UMSAE-Formula-Electric/PCB-ACU-LVPower/Schematics/2018_ACU_LVPWR_rev1.PcbDoc.htm

Reporting Options

# File in Previous Format

Date | : | 2021-02-05
Time | : | 9:37:32 PM
Filename | : | C:\Users\serge\OneDrive\Documents\UMSAE Formula Electric\2019\LV Power\trunk\2018_ACU_LVPWR_rev1.PcbDoc

Version | Warning

This file was generated by an earlier version of the software
