UMSAE-Formula-Electric/PCB-ACU-LVPower/Project Outputs for ePBR23_ACU_Power/ePBR23_ACU_Power.xlsx

Name | Description | Designator | Revision ID | Revision State | Revision Status | Quantity | Manufacturer 1 | Manufacturer Part Number 1 | Manufacturer Lifecycle 1 | Supplier 1 | Supplier Part Number 1 | Supplier Unit Price 1 | Supplier Subtotal 1
Test Via |  | 3V3, 5V, ACU_PWR, LATCHING_Delayed, UV_DELAY, VBATT_RAW, VS, VS_FROM_MS, VS_TO_MS |  | Not managed |  | 9
Cap | Capacitor | C1, C2, C11, C13 |  | Not managed |  | 4 | Samsung | CL10A106MA8NRNC | Volume Production | Digi-Key | 1276-1869-1-ND | 0.35081 | 1.4
Cap Semi | Capacitor (Semiconductor SIM Model) | C3, C12, C14, C15, C17, C18, C19, C20, C21 |  | Not managed |  | 9 | Murata | ZRB18AR61E106ME01L | Volume Production | Digi-Key | 490-10991-1-ND | 16.42 | 164.21
Cap Semi | Capacitor (Semiconductor SIM Model) | C4, C5 |  | Not managed |  | 2 | Murata | GCM188R91E104KA37D | Volume Production | Digi-Key | 490-14359-1-ND | 0.25636 | 0.51272
UUD1H101MNL1GS | Aluminum Electrolytic Capacitor, UD Series, Low Impedance, 100 uF, 50 V, + / - 20%, -55 to 105 degC, Chip Type, 8 x 10 mm D x L, Pb-Free, Reel | C6, C9 | CMP-0687-00073-1 | Released | Up to date | 2 | Nichicon | UUD1H101MNL1GS | Volume Production | Farnell | 8823391 | 0.77503 | 1.55
Cap Semi | Capacitor (Semiconductor SIM Model) | C10 |  | Not managed |  | 1 | Murata | ZRB18AR61E106ME01L | Volume Production | Digi-Key | 490-10991-1-ND | 0.87383 | 0.87383
Cap Semi | Capacitor (Semiconductor SIM Model) | C16 |  | Not managed |  | 1 | Murata | KCM55WR7YA336MH01K | Volume Production | Digi-Key | 490-5834-1-ND | 7.3 | 7.3
5-1418363-1 | Levyseal Vertical 39 pin header | CN1, CN2 |  | Not managed |  | 2
6-534998-3 |  | CON1, CON2 |  | Not managed |  | 2 | Sullins | PPPC152LFBN-RC | Volume Production | Digi-Key | S7118-ND | 2.55 | 5.1
KP-1608MGC | LED, SMT, 0603(1608), 1.1mm thickness, Green | D1, D3, D4, D8, D9, D10, D12, D13, D14, D15, D16, D17, D18, D19, D20, D21, D26 | CMP-0404-00001-1 | Released | Up to date | 17 | Kingbright | KP-1608MGC | Volume Production | Newark | 93X4293 | 0.23477 | 3.99
TLSU1008A(T04) | LED, Red 0603 (1608) 63mCd | D2, D5, D7 | CMP-0444-00001-1 | Released | Up to date | 3 | Toshiba | TLSU1008A(T04) | Obsolete | Digi-Key | 475-2512-1-ND
S8MC-13 | Default Diode | D22, D23 |  | Not managed |  | 2 | Diodes | S8MC-13 | Volume Production | Digi-Key | S8MCDICT-ND | 0.89051 | 1.78
 | 1 Amp General Purpose Rectifier | D25 |  | Not managed |  | 1 | Comchip | ACDSW4148-G | Unknown | Digi-Key | 641-1624-1-ND | 0.32382 | 0.32382
1812L050PR | POLY-FUSE(R) Resettable PTC, 0.5 A, 0.15 to 1 Ohm Resistance, -40 to 85 degC, 1812 (4532 Metric), RoHS, Tape and Reel | F1 |  | Not managed |  | 1 | Littelfuse | 1812L050PR | Volume Production | Digi-Key | F2150CT-ND | 0.67463 | 0.67463
3568 | Fuse Holder, 20 A, 500 V, -50 to 145 degC, 4-Pin THD, RoHS | F3, F4, F5, F7, F8, F9, F10, F11, F12, F13, F14, F15, F16, F17 | CMP-2000-05464-1 | Released | Up to date | 14 | Keystone Electronics | 3568 | Volume Production | Future Electronics | 4264032 | 1.04 | 14.54
39-28-1023 | Female Header, Pitch 4.2 mm, 1 x 2 Position, Height 12.8 mm, Tail Length 3.5 mm, -40 to 105 degC, RoHS | J1 | CMP-2000-05244-1 | Released | Up to date | 1 | Molex | 39-28-1023 | Volume Production | Newark | 98K8958 | 0.33866 | 0.33866
Header 2 | Header, 2-Pin | JMP2, JMP3 |  | Not managed |  | 2 | Sullins | PEC02SAAN | Volume Production | Digi-Key | S1012E-02-ND | 0.24287 | 0.48573
Jumper |  | Jumper1, Jumper2, Jumper3 |  | Not managed |  | 3 | Sullins | QPC02SXGN-RC | Volume Production | Digi-Key | S9337-ND | 0.13493 | 0.40478
6 Pin Header |  | L1, L2, L3, L4 |  | Not managed |  | 4 | TE Connectivity | 9-146285-0-06 | Volume Production | Digi-Key | A32700-06-ND | 1.31 | 5.24
LD - VND5E050JTR-E |  | LD1 |  | Not managed |  | 1 |  |  |  | Digi-Key | 497-11700-1-ND
VN5E050AJTR-E | Integrated Circuit | LD2, LD3 |  | Not managed |  | 2
PFET - FDS6675BZ | MOSFET P-CH 8-SOIC | Q7 |  | Not managed |  | 1 |  |  |  | Digi-Key | FDS6675BZCT-ND
 | N-Channel MOSFET | Q8, Q11, Q12 |  | Not managed |  | 3 | Diodes | DMG3406L-13 | Unknown | Digi-Key | DMG3406L-13DICT-ND | 0.62066 | 1.86
MCU80N03A-TP |  | Q9, Q10 |  | Not managed |  | 2
Res1 | Resistor | R1, R15 |  | Not managed |  | 2 | Yageo | RC0603JR-0782RL | Volume Production | Digi-Key | 311-82GRCT-ND | 0.8434 | 8.43
Res1 | Resistor | R2 |  | Not managed |  | 1 | Yageo | RC0603JR-0782RL | Volume Production | Digi-Key | 311-82GRCT-ND | 0.18205 | 0.18205
RES0603 | 0603 (1608 Metric) Chip Resistor | R3, R11, R12, R13, R14, R16, R17, R18, R21, R22, R23, R25, R26, R27, R28, R29, R30, R31, R32, R33, R34, R36, R37, R38, R39, R40, R41, R42, R47, R48, R49, R70, R71 | CMP-1591-00001-1 | Released | Up to date | 33 | NoManufacturer | RES0603 | Unknown | Digi-Key, [NoParam] | P560BZCT-ND, [NoParam], P430BZCT-ND, 311-10KGRCT-ND, P1.00KHCT-ND
Res1 | RES SMD 33K OHM 5% 1/4W 0603 | R9 |  | Not managed |  | 1 |  |  |  | Digi-Key | RHM33KDCT-ND
Res1 | Resistor | R10 |  | Not managed |  | 1 | Yageo | RC0603JR-07180RL | Volume Production | Digi-Key | 311-180GRCT-ND | 0.13493 | 0.13493
Res1 | RES SMD 10K OHM 5% 1/4W 0603 | R43, R44, R45, R50 |  | Not managed |  | 4 | Rohm | ESR03EZPJ103 | Volume Production | Digi-Key | RHM10KDCT-ND | 0.1754 | 0.70161
Res1 | RES SMD 100 OHM 5% 1/4W 0603 | R46 |  | Not managed |  | 1 | Rohm | ESR03EZPJ101 | Volume Production | Digi-Key | RHM100DCT-ND | 0.1754 | 0.1754
5.6R | Resistor | R69 |  | Not managed |  | 1 | Riedon | PF2203-5R6F1 | Volume Production | Digi-Key | 696-1688-5-ND
Volt Reg | Voltage Regulator | U1, U6 |  | Not managed |  | 2 |  |  |  | Digi-Key | 811-3014-ND, 811-2692-ND
ACS712ELCTR-20A-T | Linear Current Sensor IC, 4.5 to 5.5 V Supply Voltage, 10 mA Supply Current, -40 to 85 degC, 8-Pin SOIC (LC), RoHS, Tape and Reel | U2 | CMP-0826-00001-1 | Released | Out of date | 1 | Allegro MicroSystems | ACS712ELCTR-20A-T | Volume Production | Farnell | 1329624 | 7.9 | 7.9
NE555DR | Precision Timer, 4.5 to 16 V, 0 to 70 degC, 8-Pin SOIC (D8), Green (RoHS & no Sb/Br), Tape and Reel | U4, U8 | CMP-1685-00007-1 | Released | Out of date | 2 | Texas Instruments | NE555DR | Volume Production | Mouser | 595-NE555DR | 0.60716 | 1.21
LTC4365ITS8#TRMPBF | UV, OV and Reverse Supply Protection Controller, 2.5 to 34 V Vin, 8-pin SOT23 (TS8-8), -40 to 85 degC, Pb-Free, Mini Tape and Reel | U7 | CMP-0474-00861-1 | Released | Up to date | 1 | Analog Devices / Linear Technology | LTC4365ITS8#TRMPBF | Volume Production | Digi-Key | LTC4365ITS8#TRMPBFCT-ND
WM9796-ND | Header, 2-Pin | WM1, WM2 |  | Not managed |  | 2 | Molex | 42819-2214 | Volume Production | Digi-Key | WM11908-ND | 5.29 | 10.58
