UMSAE-Formula-Electric/PCB-ACU-LVPower/AltiumDesigner/C226S_COT.step

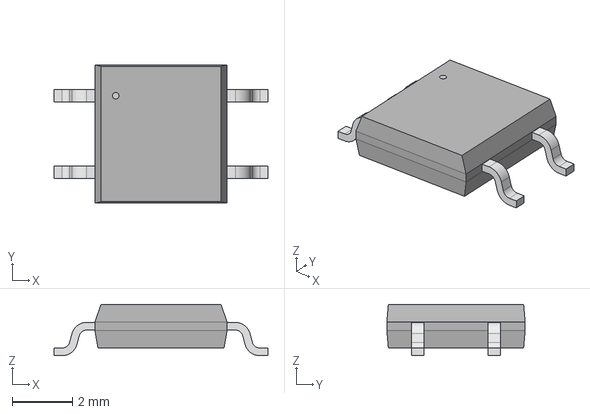
[picture p1: CAD file, 2025-08-28]
AltiumDesigner/C226S_COT.step
7.11 x 4.60 x 1.70 mm
