UMSAE-Formula-Electric/PCB-ACU-LVPower/(list of files, cad)

Other CAD files:
C226S_COT.step
