UMSAE-Formula-Electric/PCB-ACU-LVPower/(threads)

Thread 3 (2025-08-10):

Wiring from ACU to Aux tray

MitchHewitt, 2025-08-10:
**Harnessing which runs from ACU to Aux tray**

there is 39 pin connector on the left side of the ACU-LVPWR board (as viewed from Infront of PCB). this 39 pin connector runs directly to the Aux Tray

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

The above picture shows the connector positions with the appropriate pin numbers

Reference document
https://www.rbracing-rsr.com/wiring_ecu.html

EXPECTATIONS:
Following typical wire colour style (BLACK- GND, RED- PWR, BLUE,PINK,GREEN,- SIGNAL)
Wire Labels are marked with heat shrink labels as per label on PCB and in picture above
CAN Wire made with twisted pair shielded cable, shielding runs to ground
Full cable wrapped with self vulcanizing tape after completed
Continuity testing of each pin after completion

Thread 4 (2025-08-10):

Aux tray dummy connector removal and replacement

MitchHewitt, 2025-08-10:
We will be removing and replacing the Charging connector from the AUX tray and Charge cart and replacing with a solution that allows for all interfacing to be done with the same connectors. this means that there would be no more 'dummy' connections on the aux tray when driving or charging.

Current setup:
Charge has a 4 position orange cable which runs from the output of the charger to the Aux tray, the 4 position cable only carries 2 conductors all the way through, HV+ and HV- to charge. the remaining 2 positions are only at the aux tray side, used as an interlock for when the connection is made to maintain Charge cart Safety loop. We want to entirely eliminate this cable and charge only using the HV+ and HV- terminals which are already on the aux tray.

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

Thread 5 (2025-08-10):

Part selection for 2 position HV connector on side of Charge cart control box (Must have interlock)

MitchHewitt, 2025-08-10:
This change forces us to replace the black wire (wrapped with orange loom) with two high current wires and a bulkhead connector on the side of the controller box. This connector must have a safety loop interlock. and ideally it would not be a wire input safety loop interlock (as in a 4 pin connector with 2 high current 2 low current). we want a connector similar to an Amphenol powerlok but for two position and bulkhead.

Current suggestions:

AC-HA000767

This selection is made because it is likely we could get it sponsored, it interfaces with the powerloks we already have, and amphenol is a reliable local company.

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

Thread 8 (2025-08-20):

LV Battery Characterization

MitchHewitt, 2025-08-20:
Use the battery discharger to run a full discharge curve on the LV Batteries we use.

Make sure the LV Battery is fully charged (14V at least) before testing
Monitor the battery as the discharge is happening

https://hobbyking.com/en_us/turnigy-high-capacity-battery-20000mah-4s-12c-drone-lipo-pack-xt90.html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[bW9kZT03JnBhZ2U9MSZxdWVzdGlvbl9zZWFyY2hfY29udGVudD0mcT0yMzAz]
