UMSAE-Formula-Electric/PCB-ACU-LVPower/Schematics/ePBR20_ACU_Power_rev1.pdf

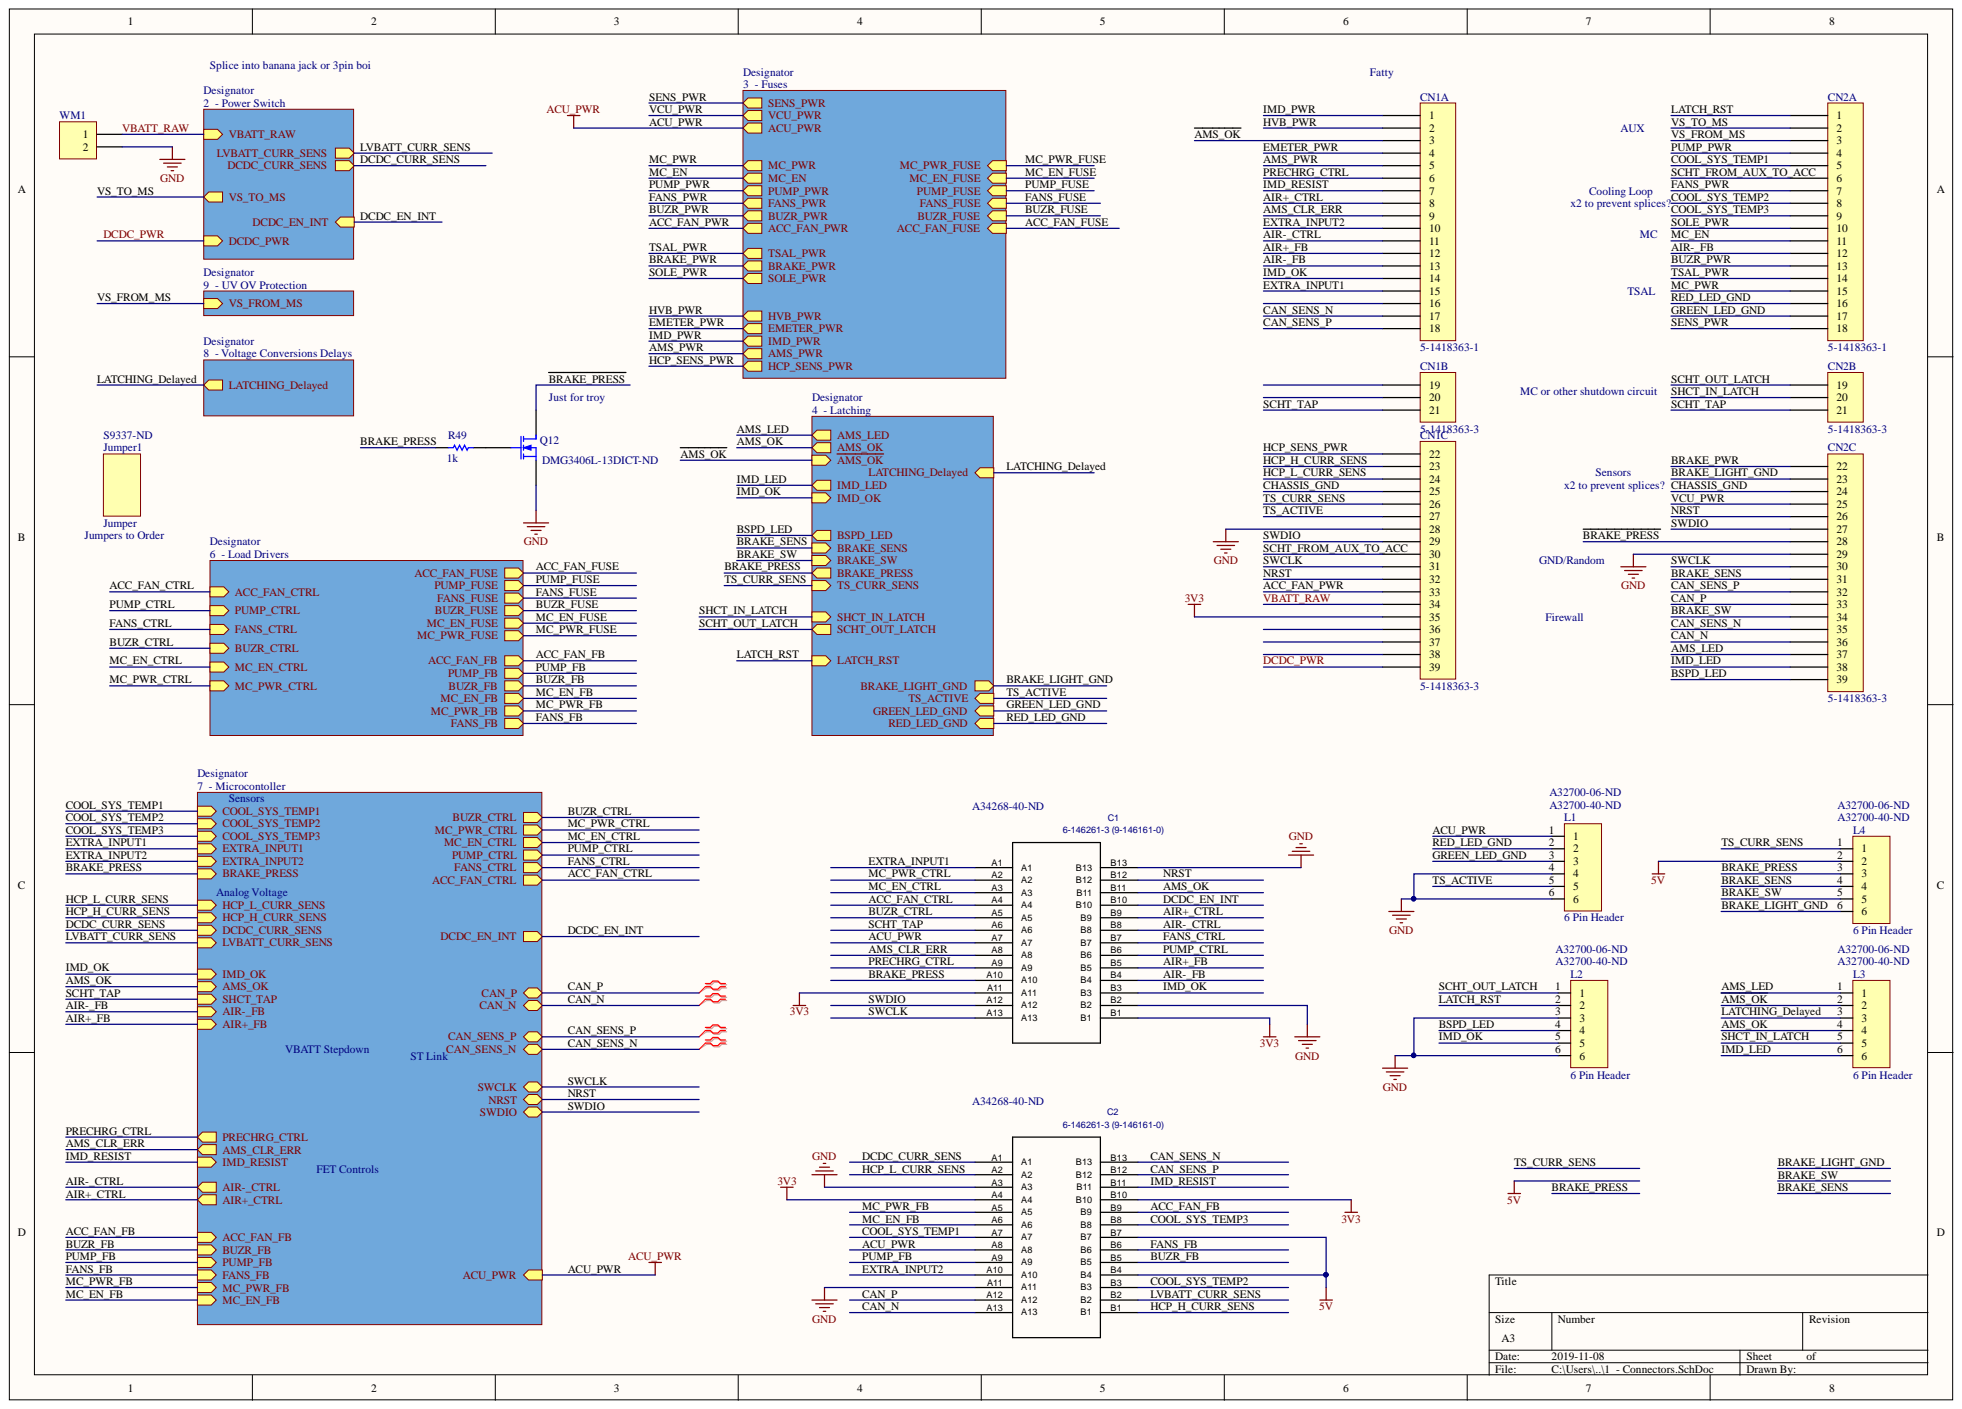
[picture p2: page 1]

Splice into banana jack or 3pin boi

MC or other shutdown circuit

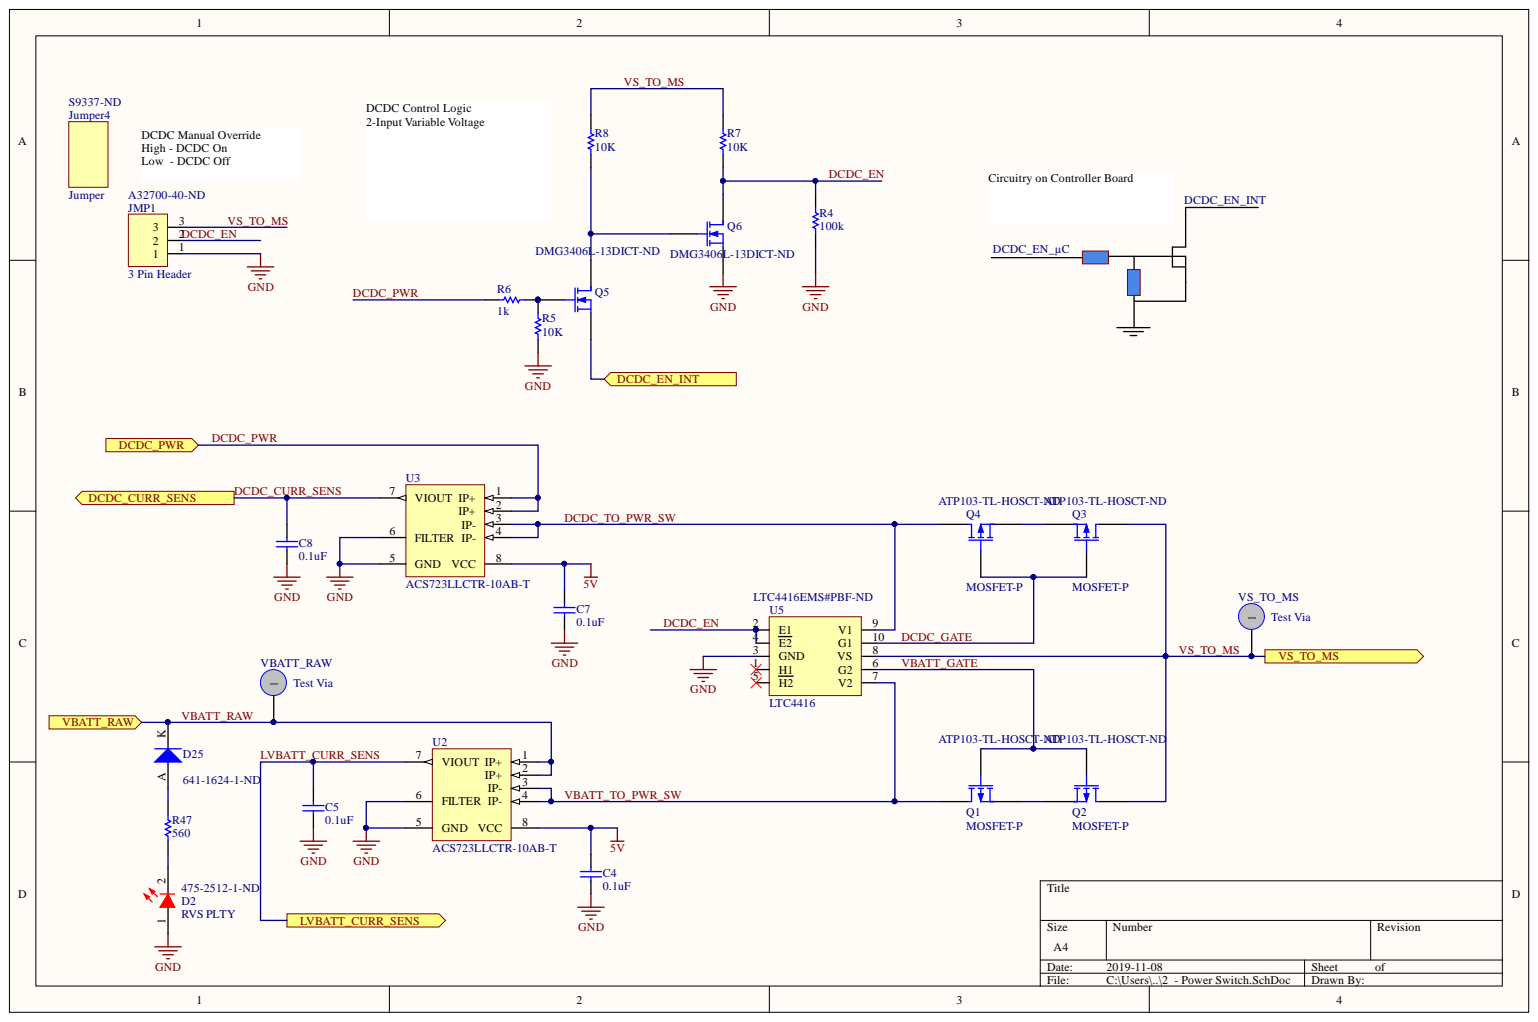
[picture p3: page 2]

Circuitry on Controller Board

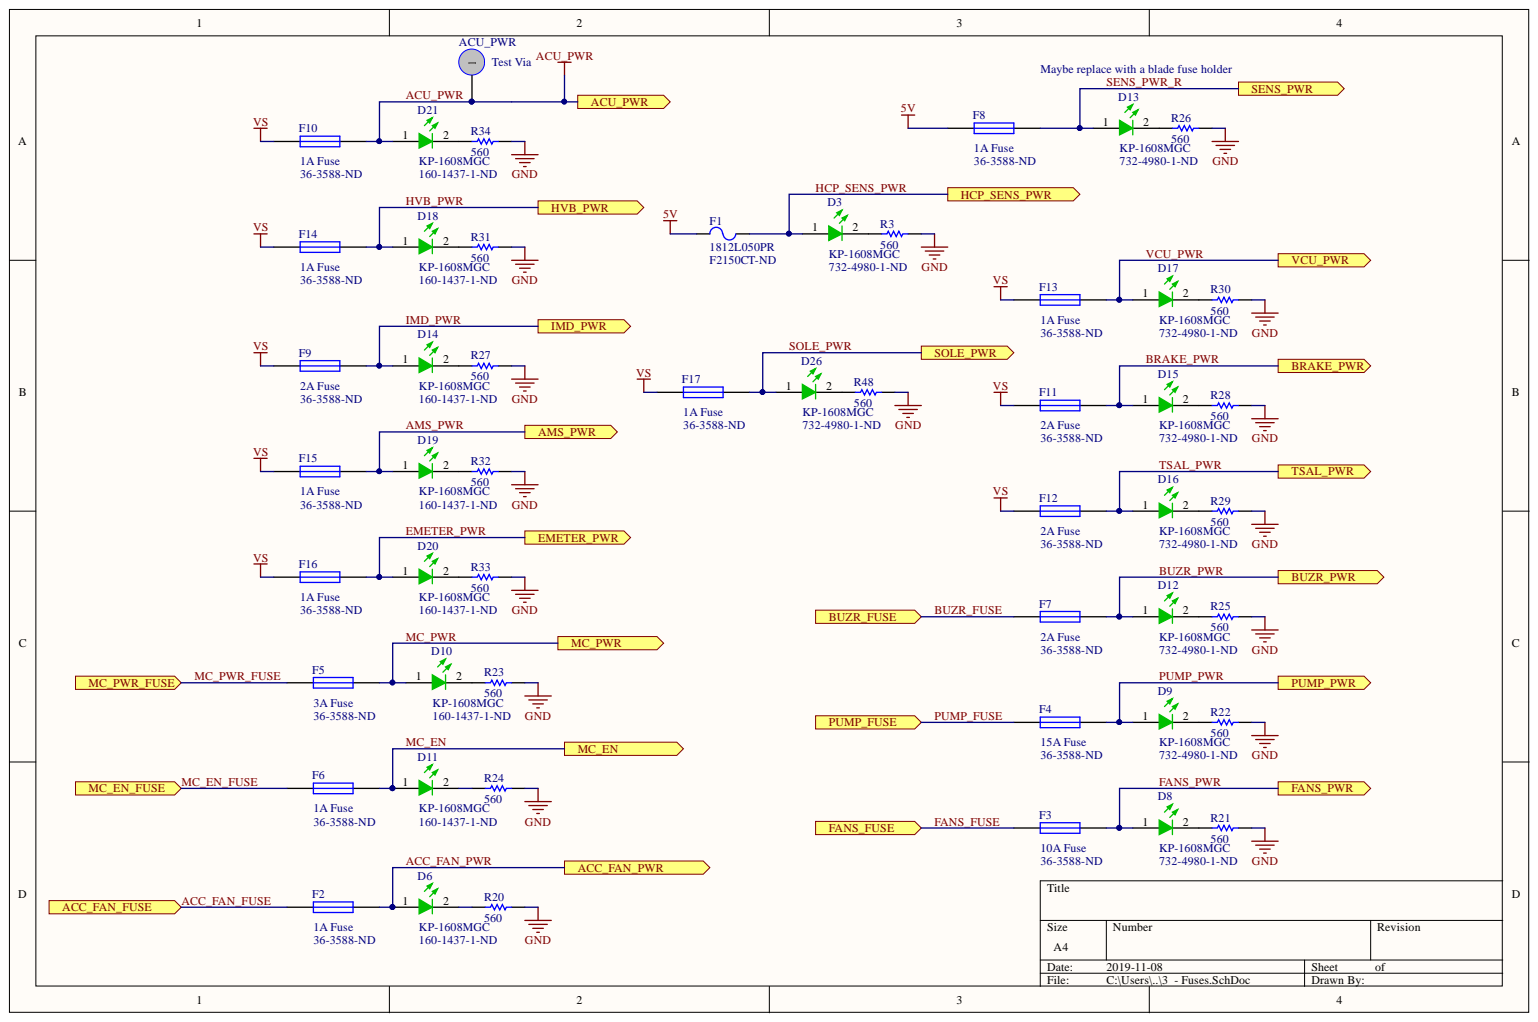
[picture p4: page 3]

Maybe replace with a blade fuse holder

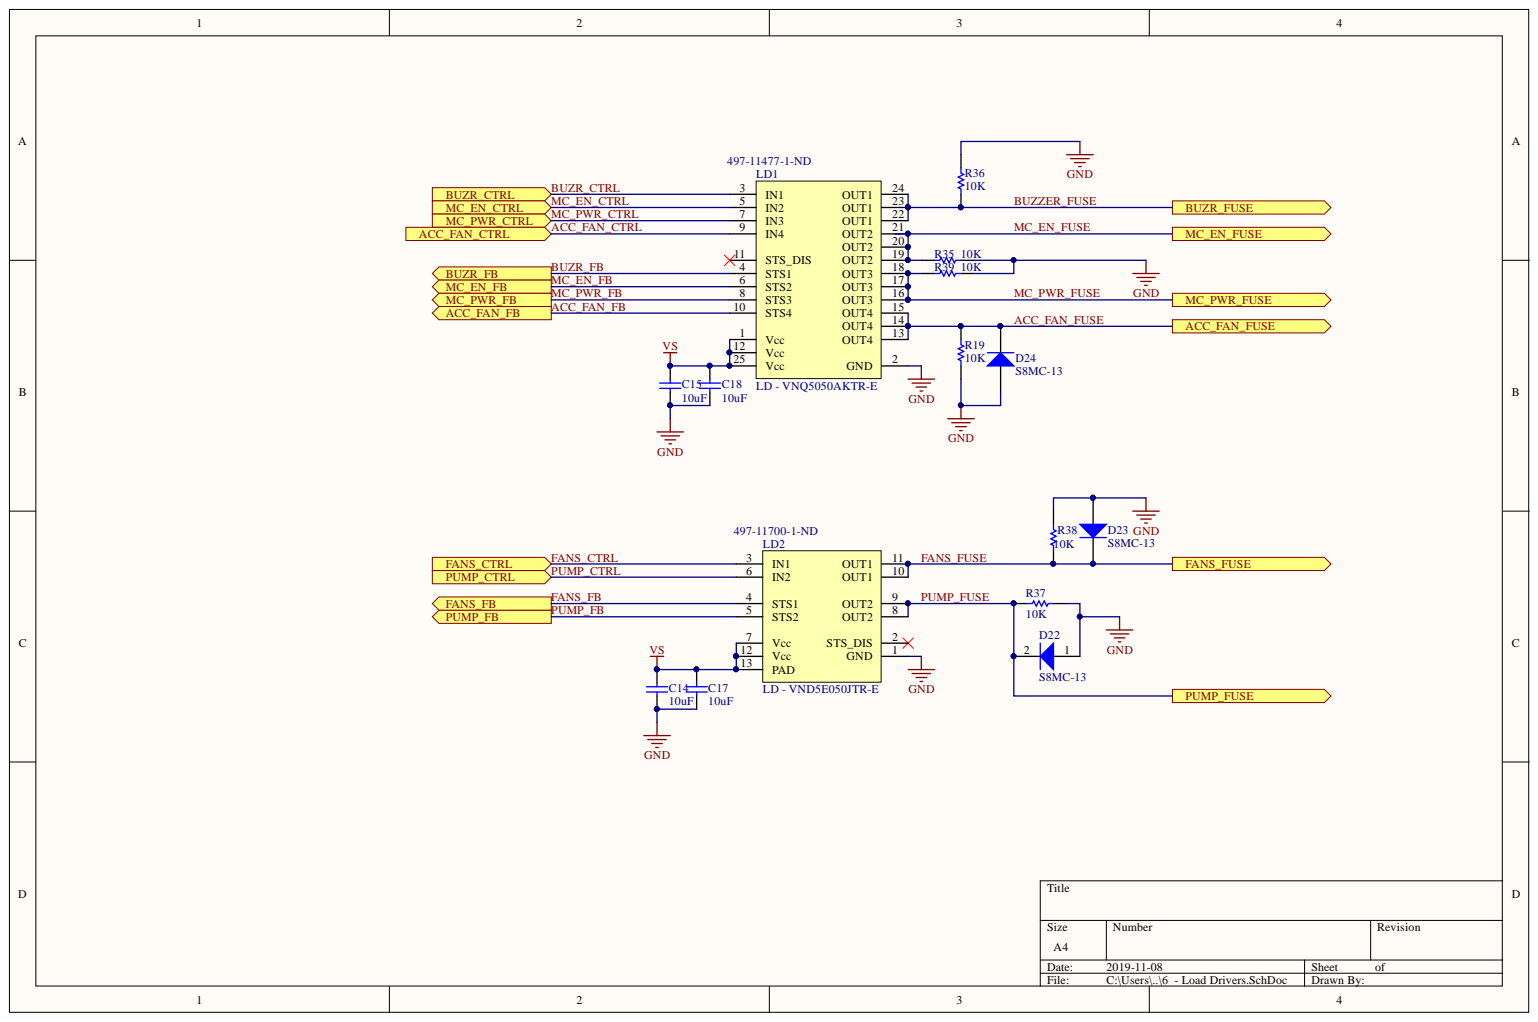
[picture p5: page 4]

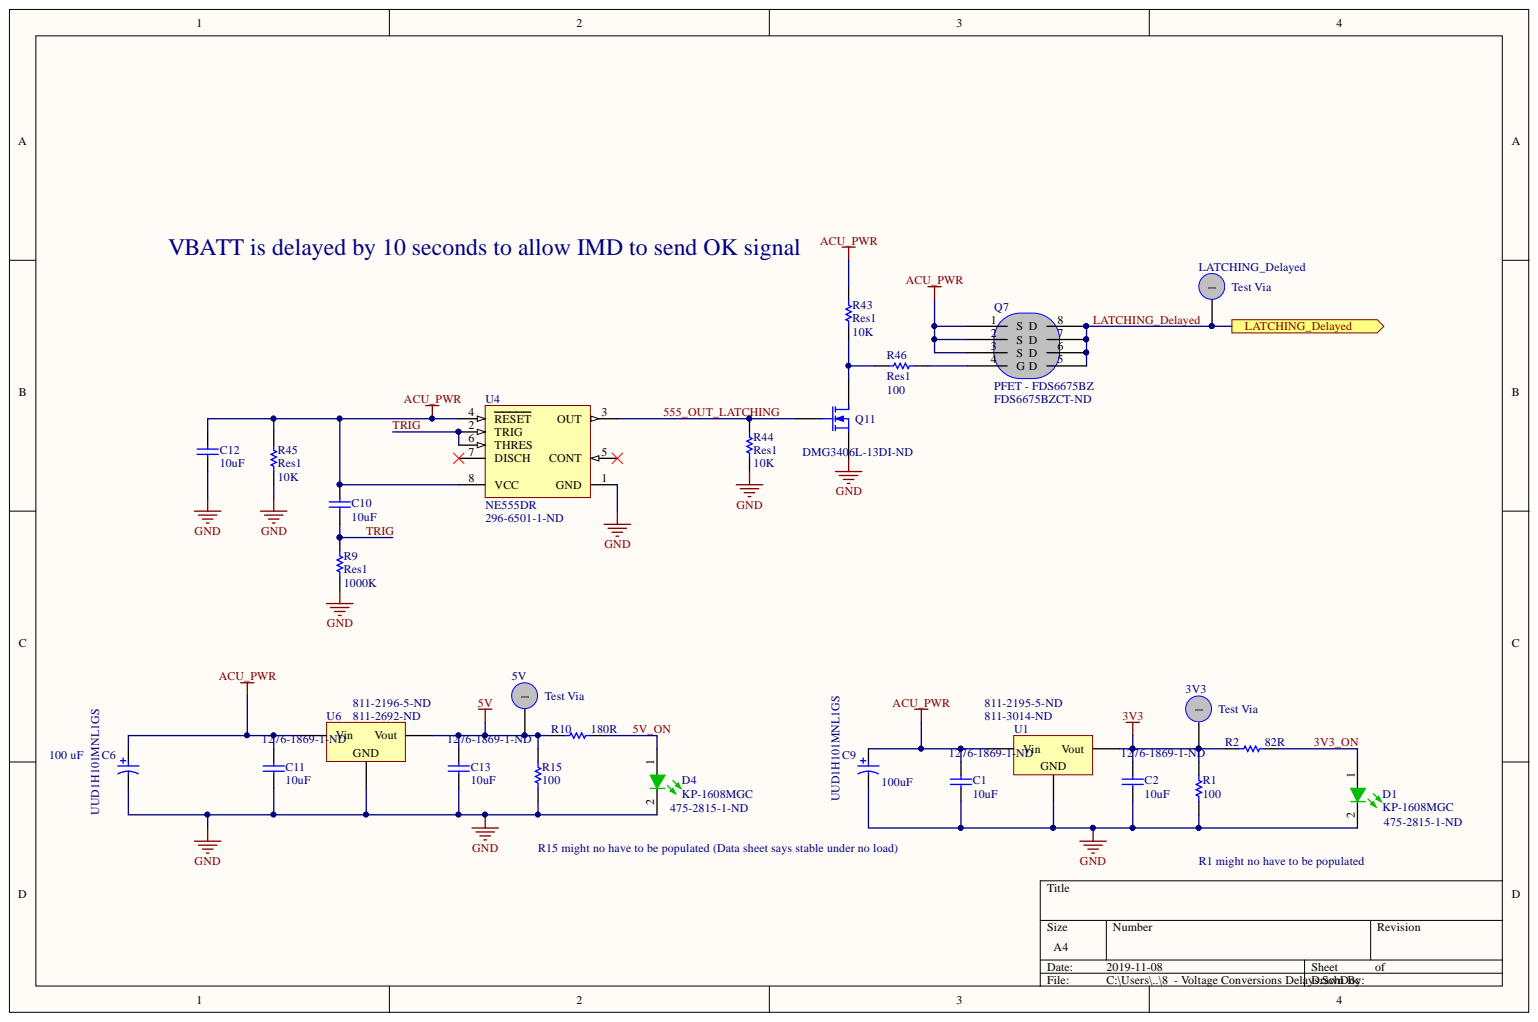
[picture p6: page 5]

VBATT is delayed by 10 seconds to allow IMD to send OK signal

R15 might no have to be populated (Data sheet says stable under no load)

R1 might no have to be populated

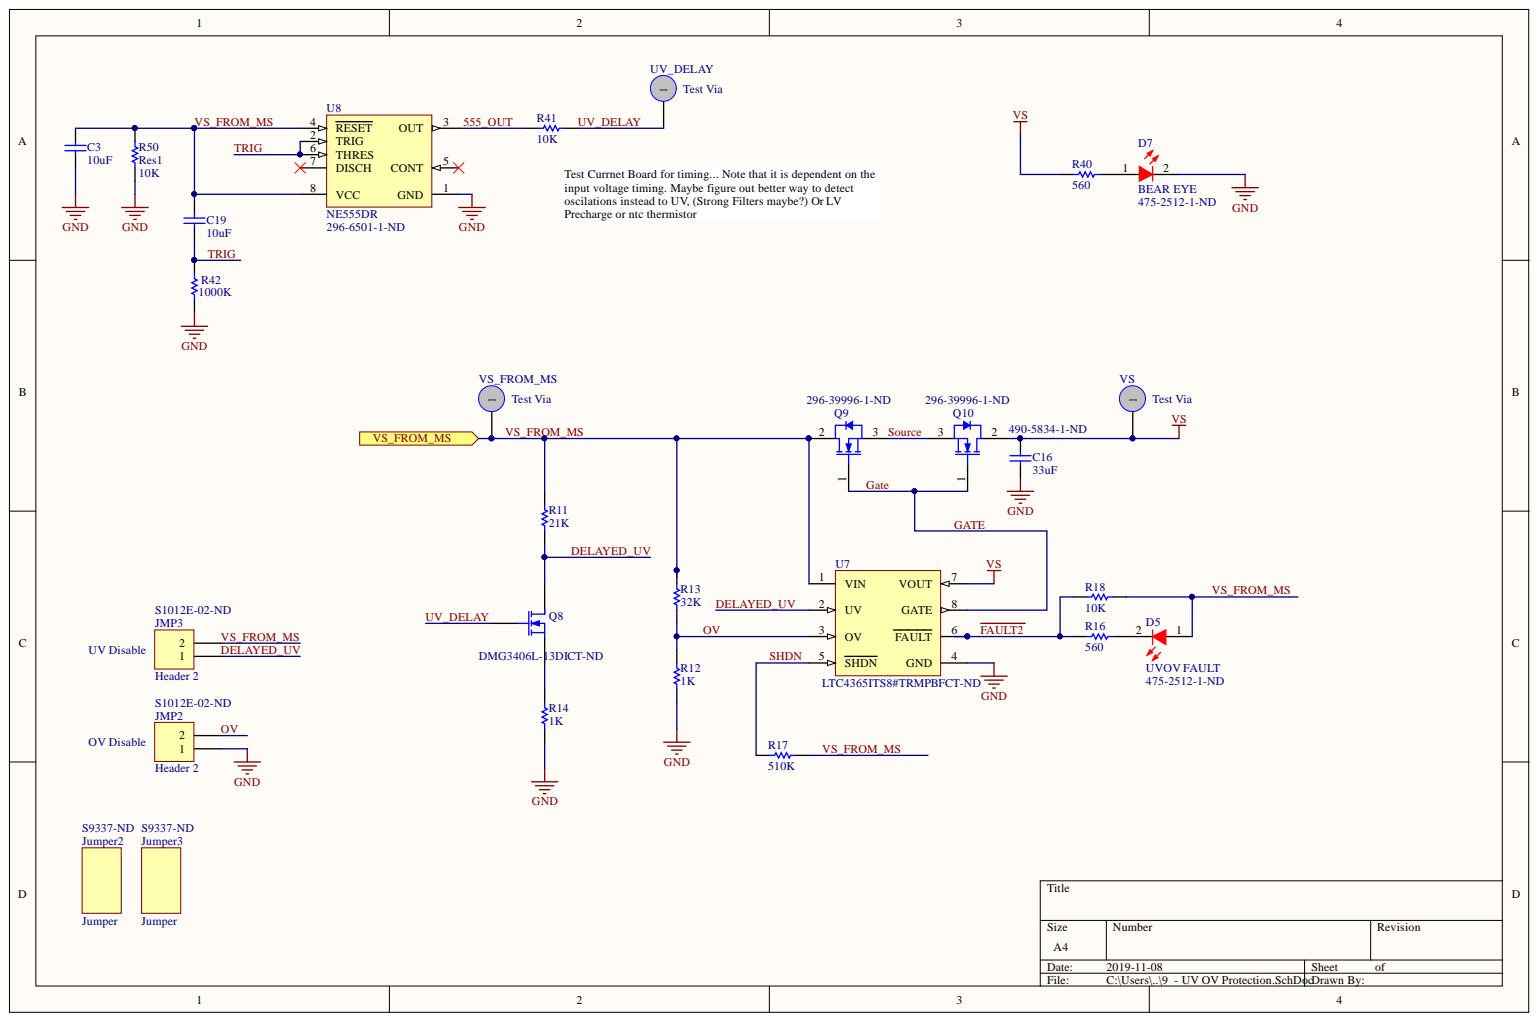
[picture p7: page 6]

Test Currnet Board for timing... Note that it is dependent on the
input voltage timing. Maybe figure out better way to detect
oscilations instead to UV, (Strong Filters maybe?) Or LV
Precharge or ntc thermistor

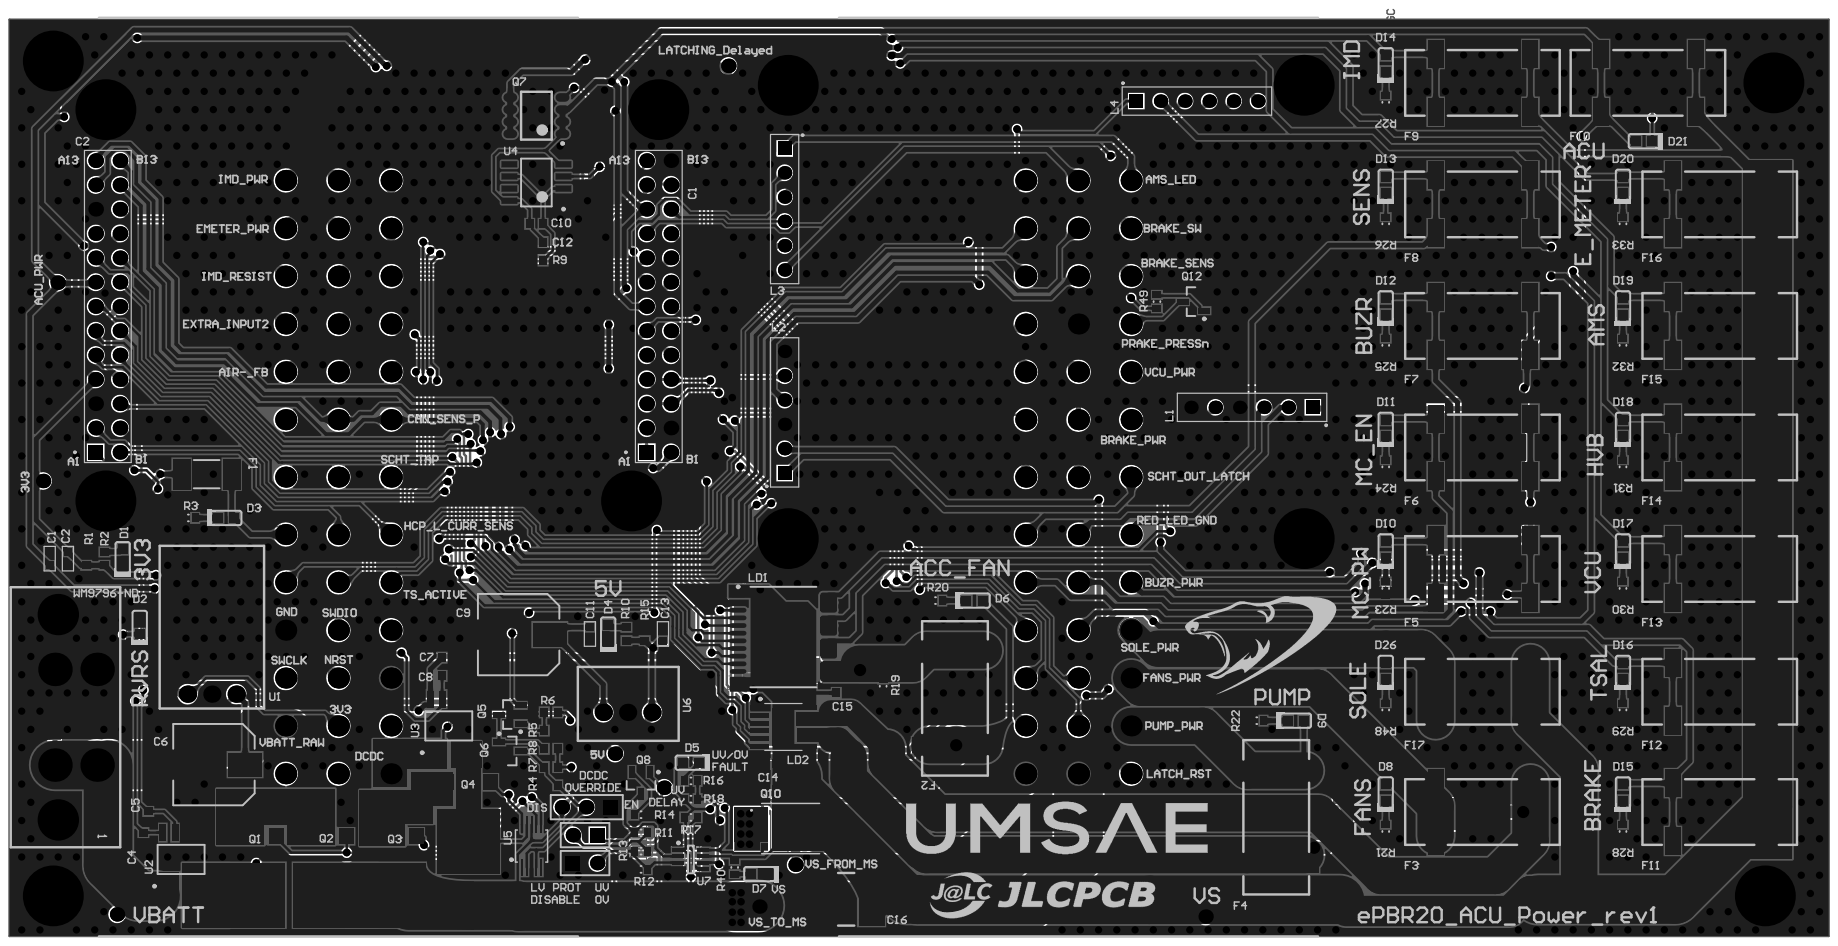
[picture p8: page 7]
