UMSAE-Formula-Electric/PCB-ACU-LVPower/ePBR25_ACU_Power.pdf

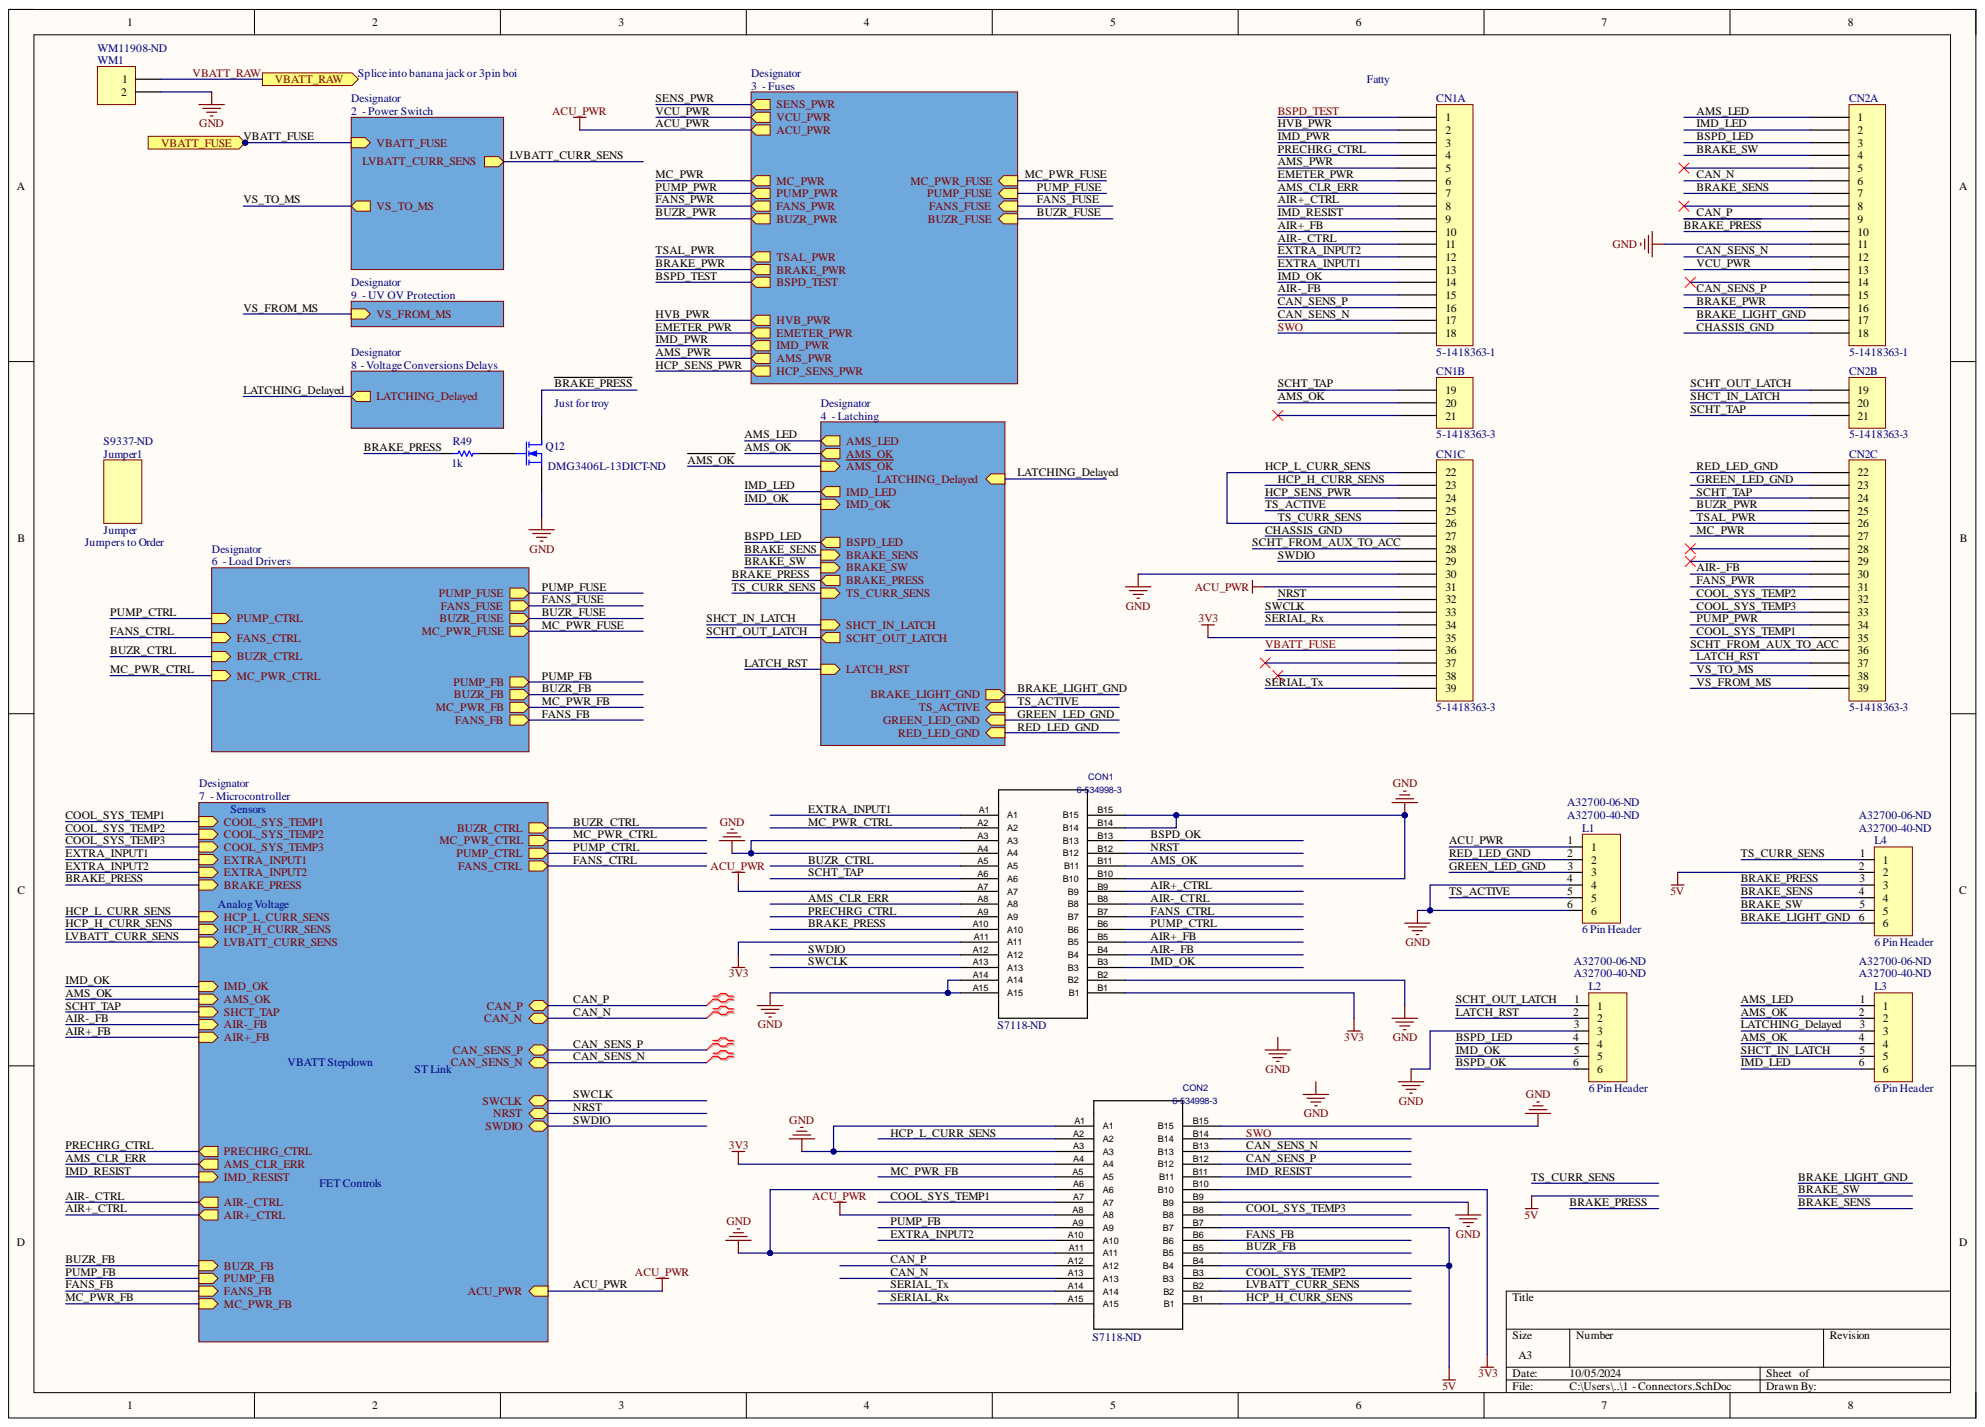
[picture p9: page 1]

Splice into banana jack or 3pin boi

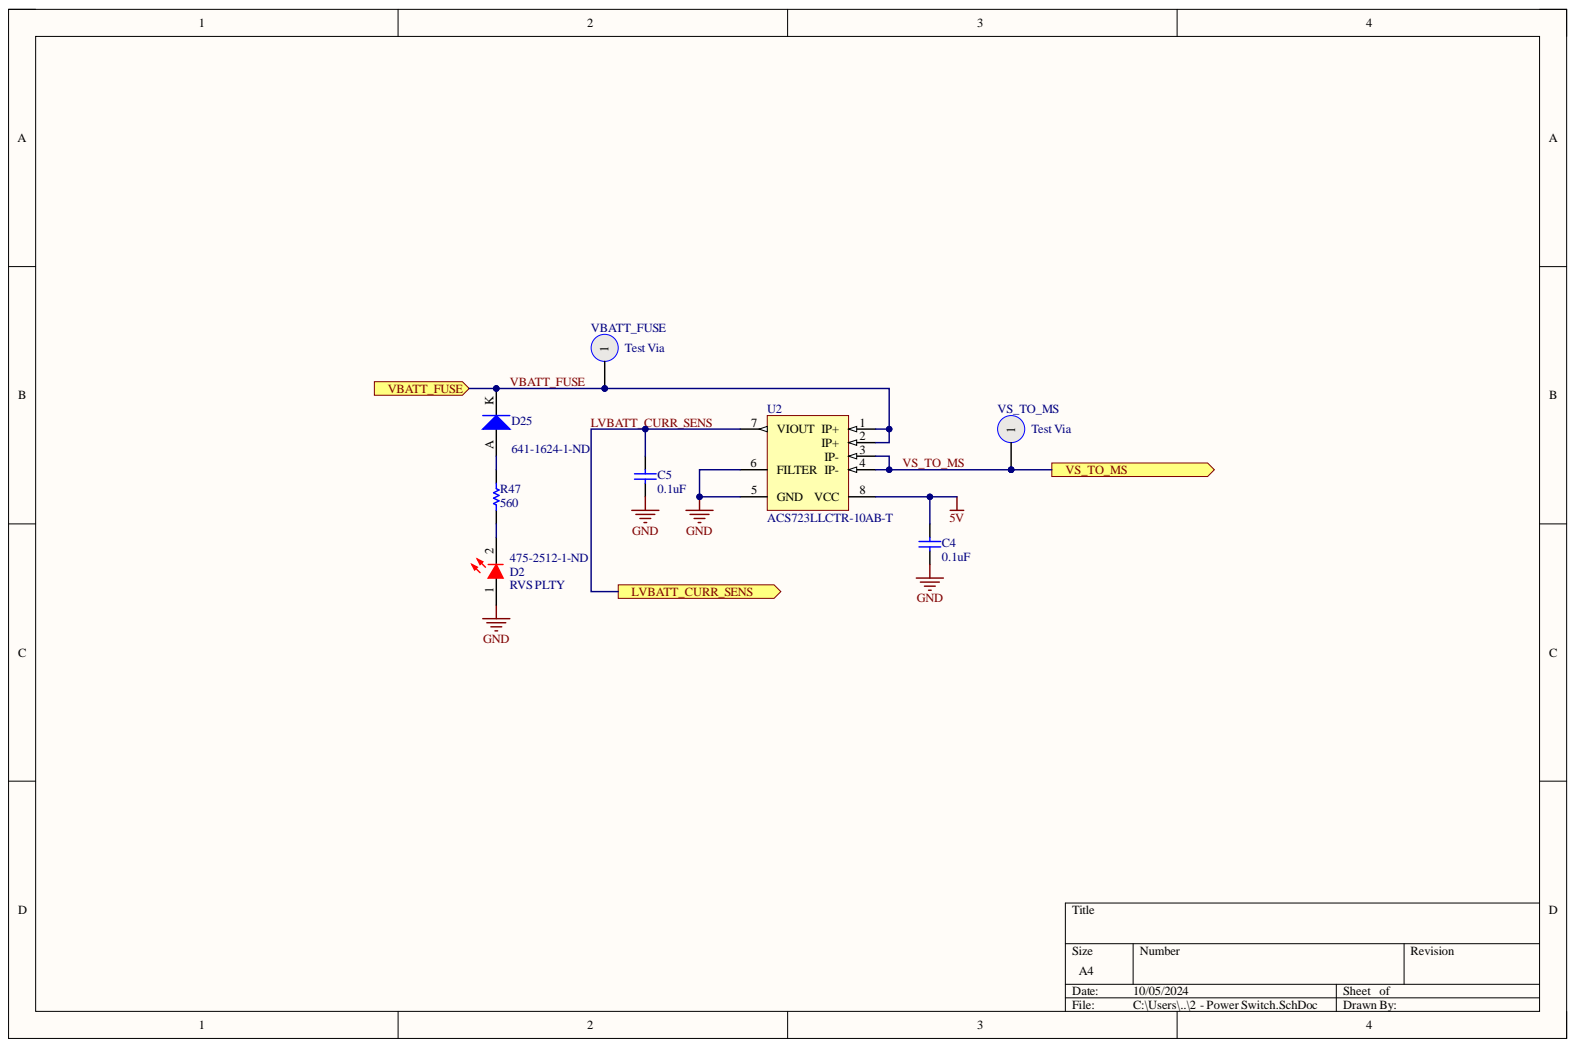
[picture p10: page 2]

Siz e A4 | Numb e r | R evisio n

Da te : 10/05/20 24 | She et of
File : C:\Use rs\. .\2 -Powe r Switch. S chD o c | Dr awn B y :

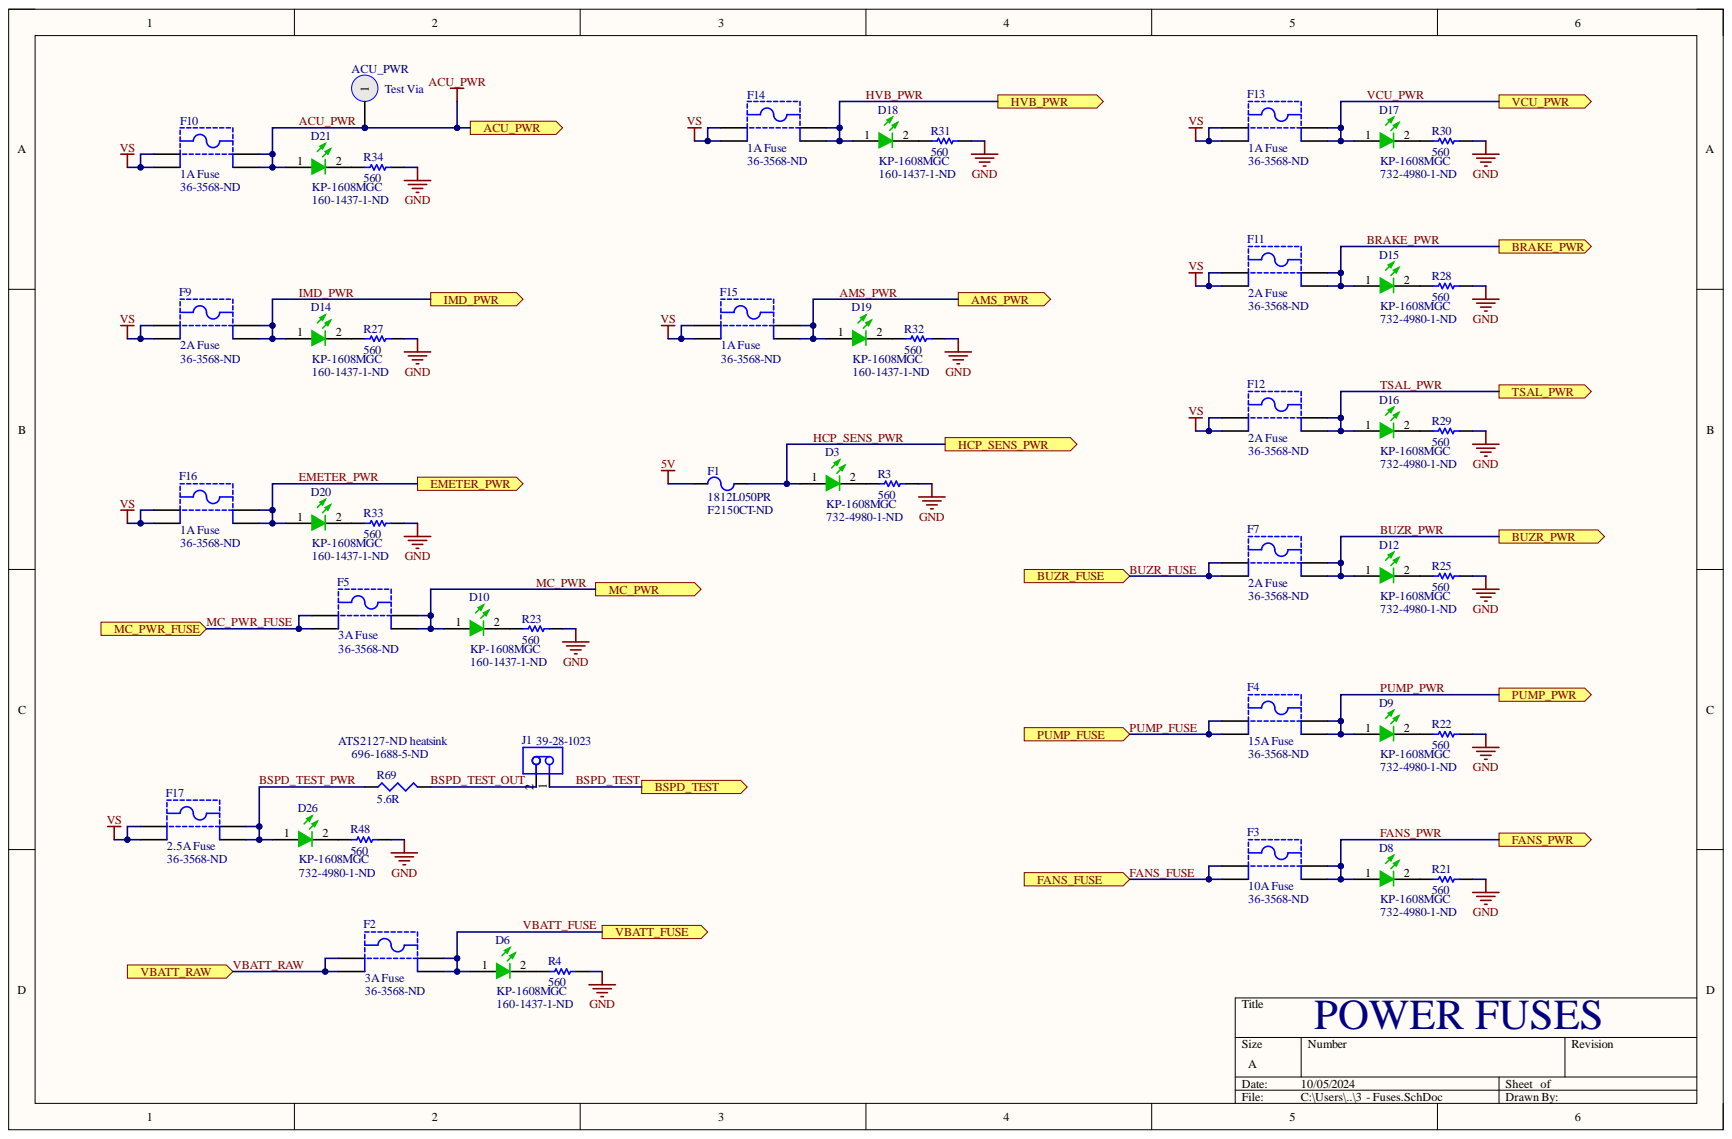
[picture p11: page 3]

Size A | Number | Revision

Date: 10/05/2024 | Sheet of
File: C:\Users\..\3 - Fuses.SchDoc | Drawn By:

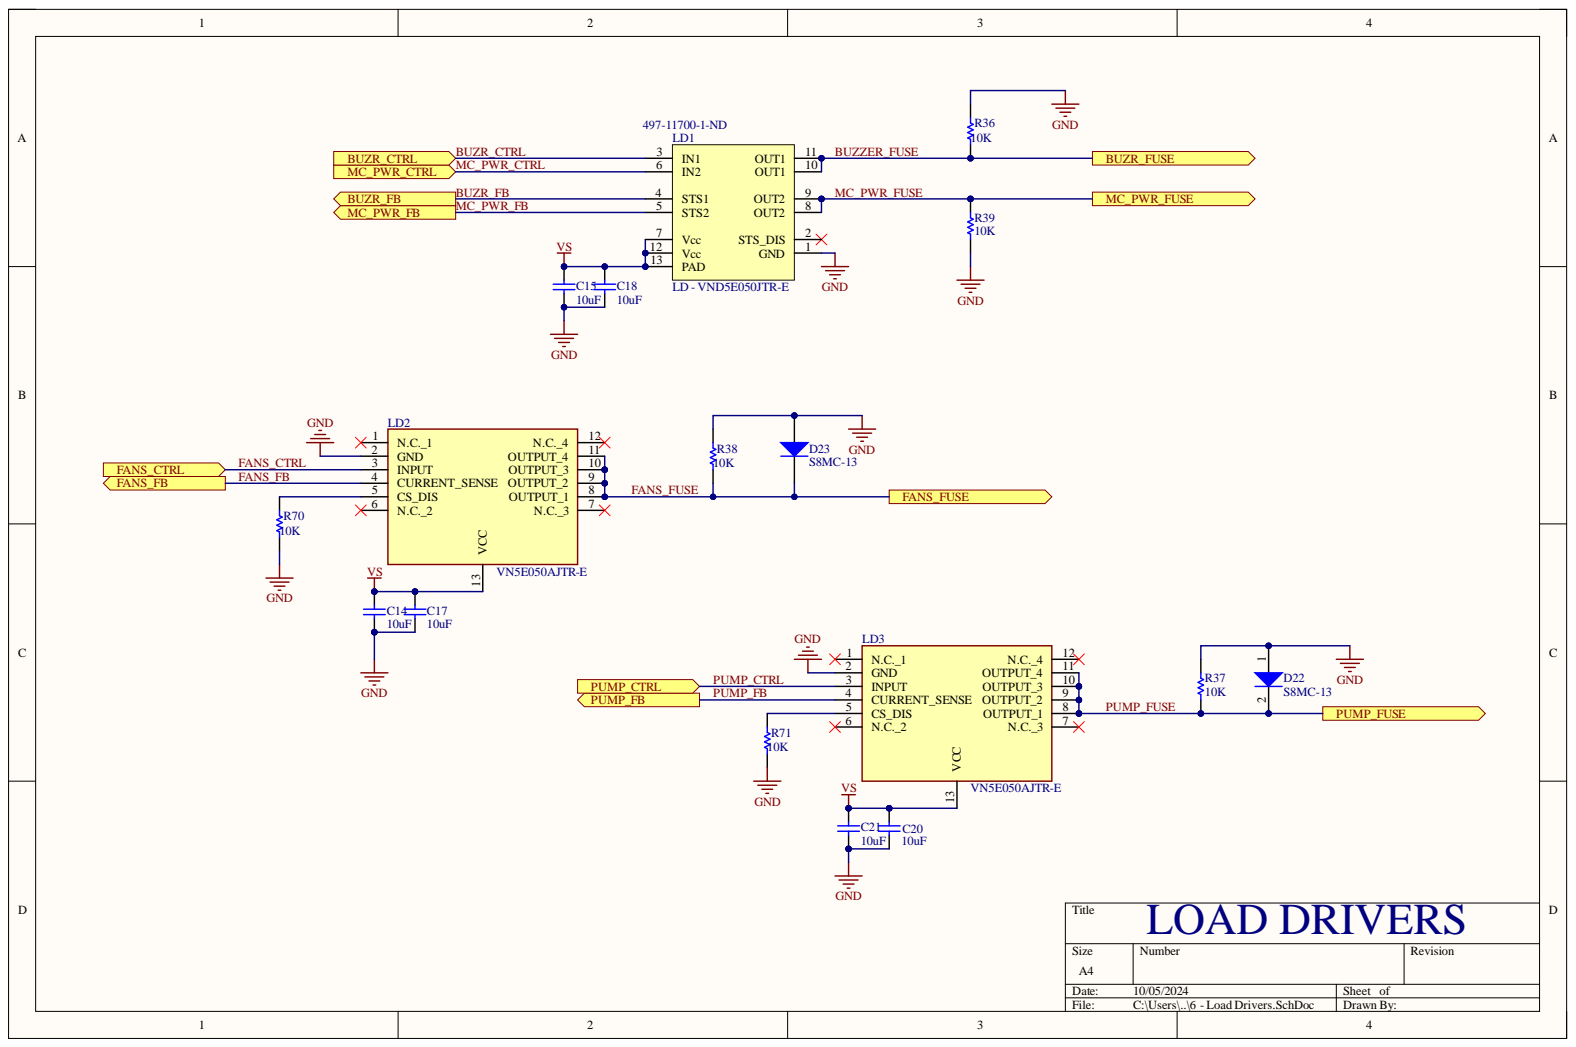
[picture p12: page 4]

Size A4 | Number | Revision

Date: 10/05/2024 | Sheet of
File: C:\Users\..\6 - Load Drivers.SchDoc | Drawn By:

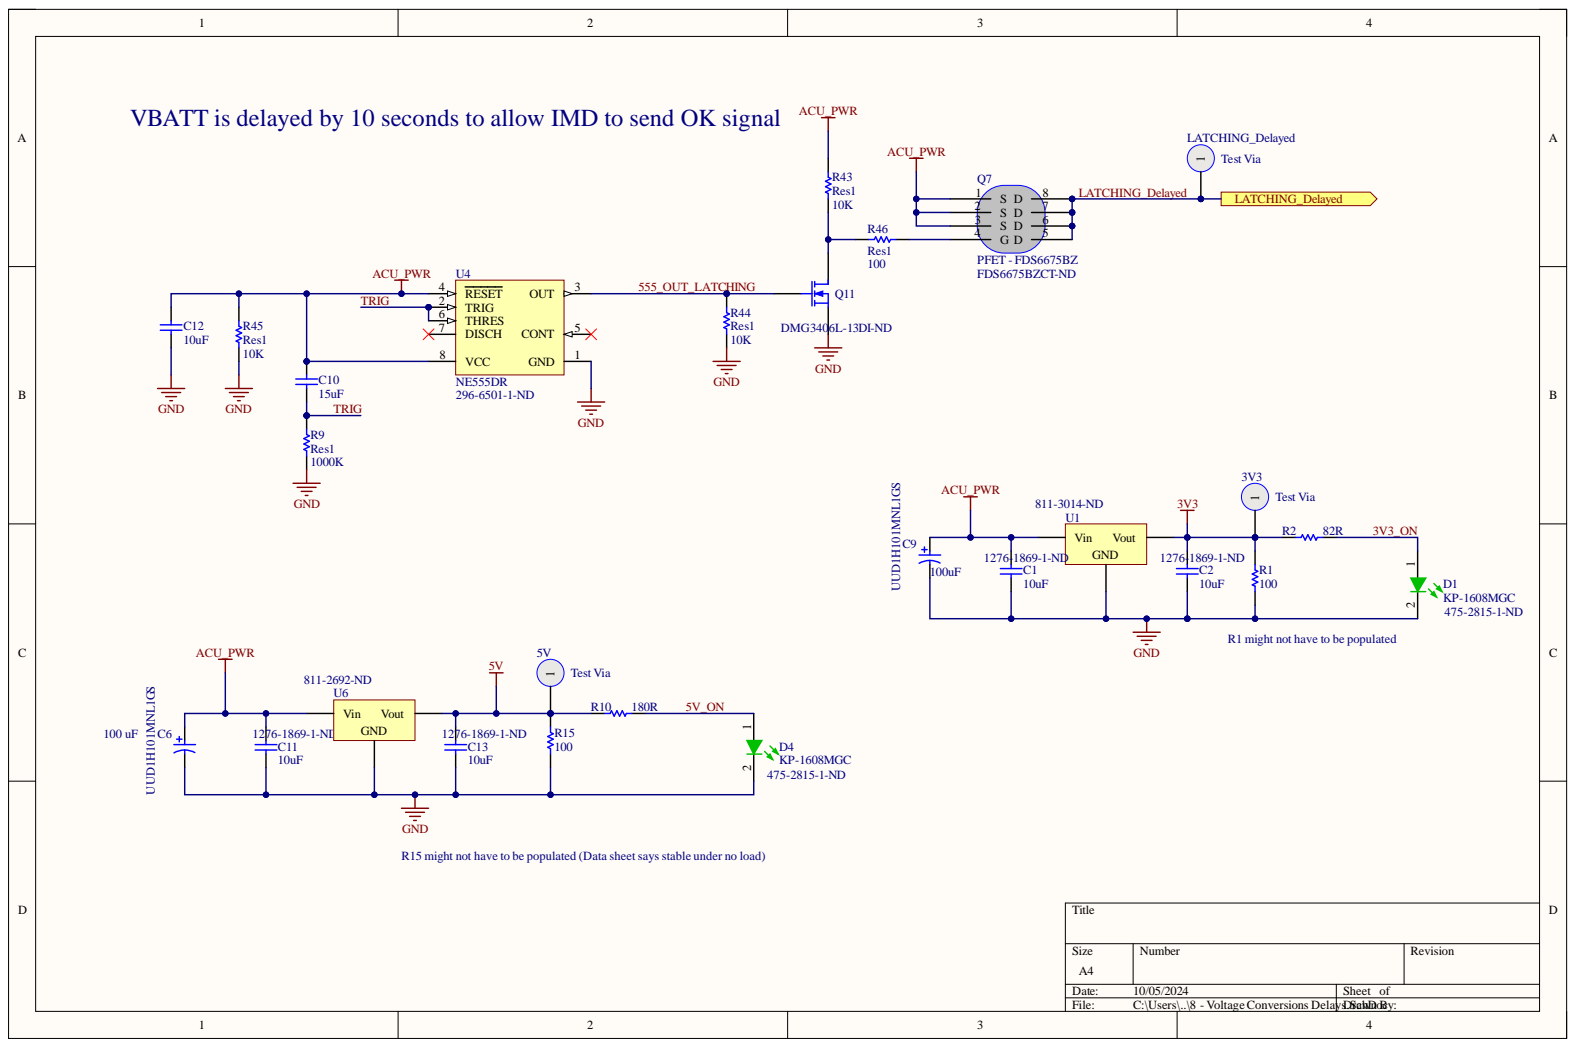
[picture p13: page 5]

VBATT is delayed by 10 seconds to allow IMD to send OK signal

R1 might not have to be populated

R15 might not have to be populated (Data sheet says stable under no load)

Size A4 | Number | Revision

Date: 10/05/2024 | Sheet of
File: C:\Users\..\8 - VoltageConversions Delays.DrScahwn DoBcy:

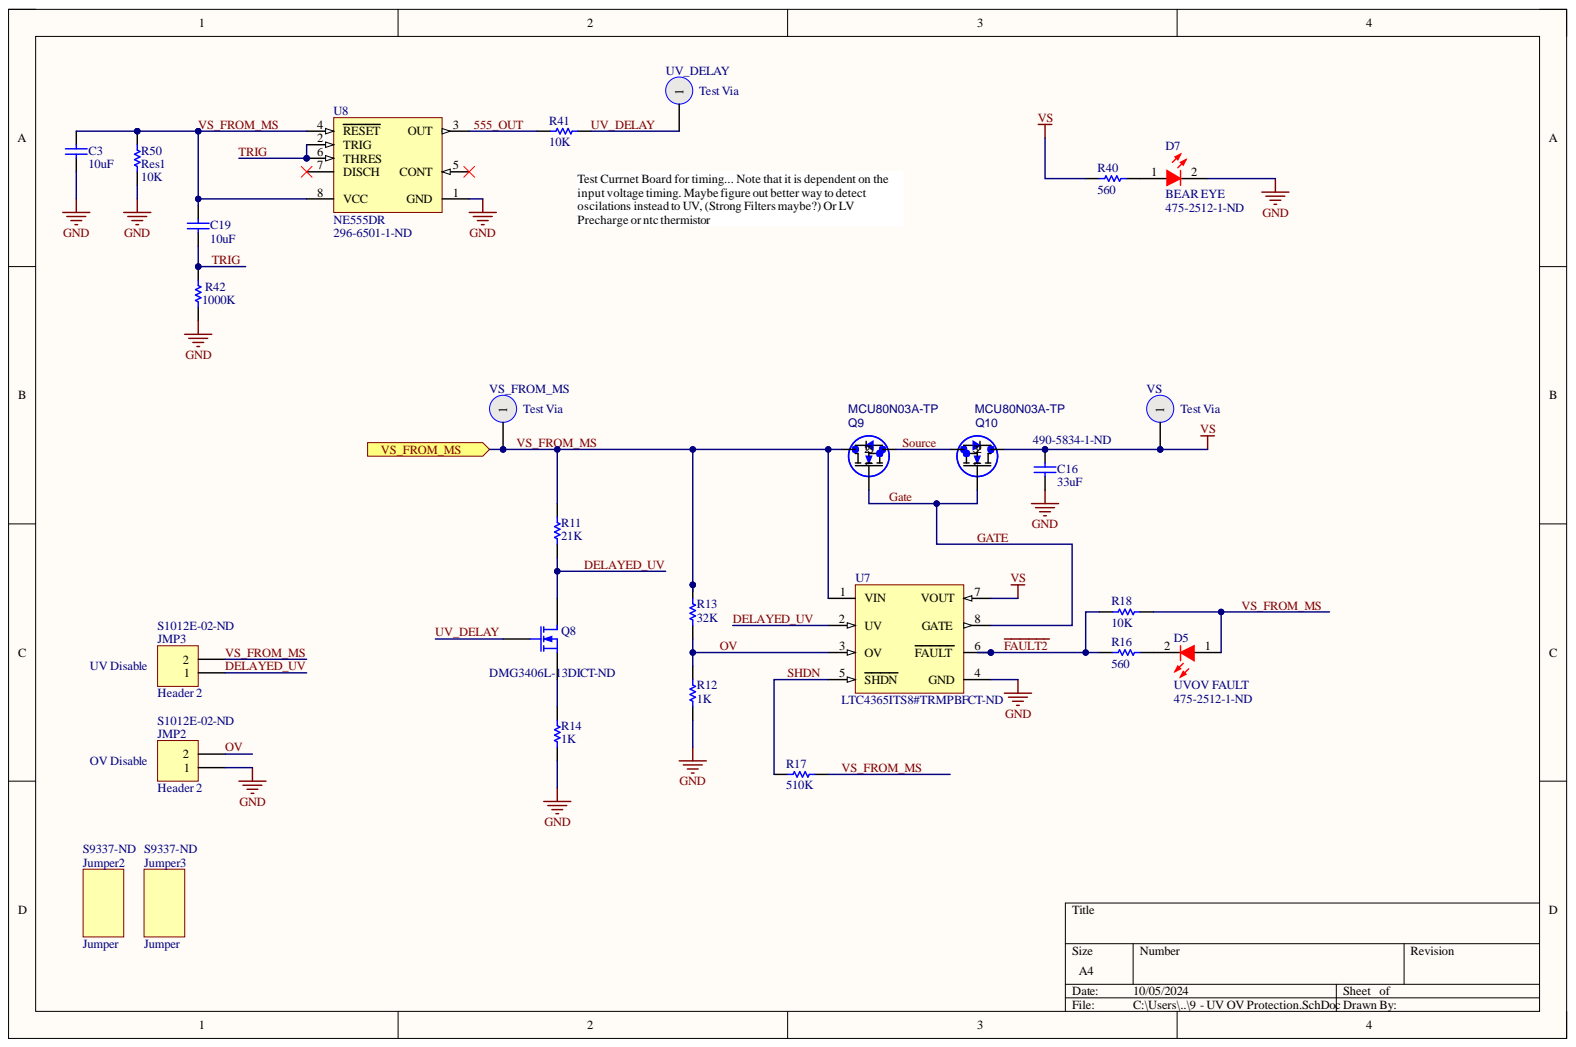
[picture p14: page 6]

Test Currnet Board for timing... Note that it is dependent on the
input voltage timing. Maybe figure out better way to detect
oscilations instead to UV, (Strong Filters maybe?) Or LV
Precharge or ntc thermistor

Size A4 | Number | Revision

Date: 10/05/2024 | Sheet of
File: C:\Users\..\9 - UV OV Protection.SchDoc Drawn By:
