UMSAE-Formula-Electric/PCB-ACU-LVPower/ePBR23_ACU_Power_Dec03.pdf

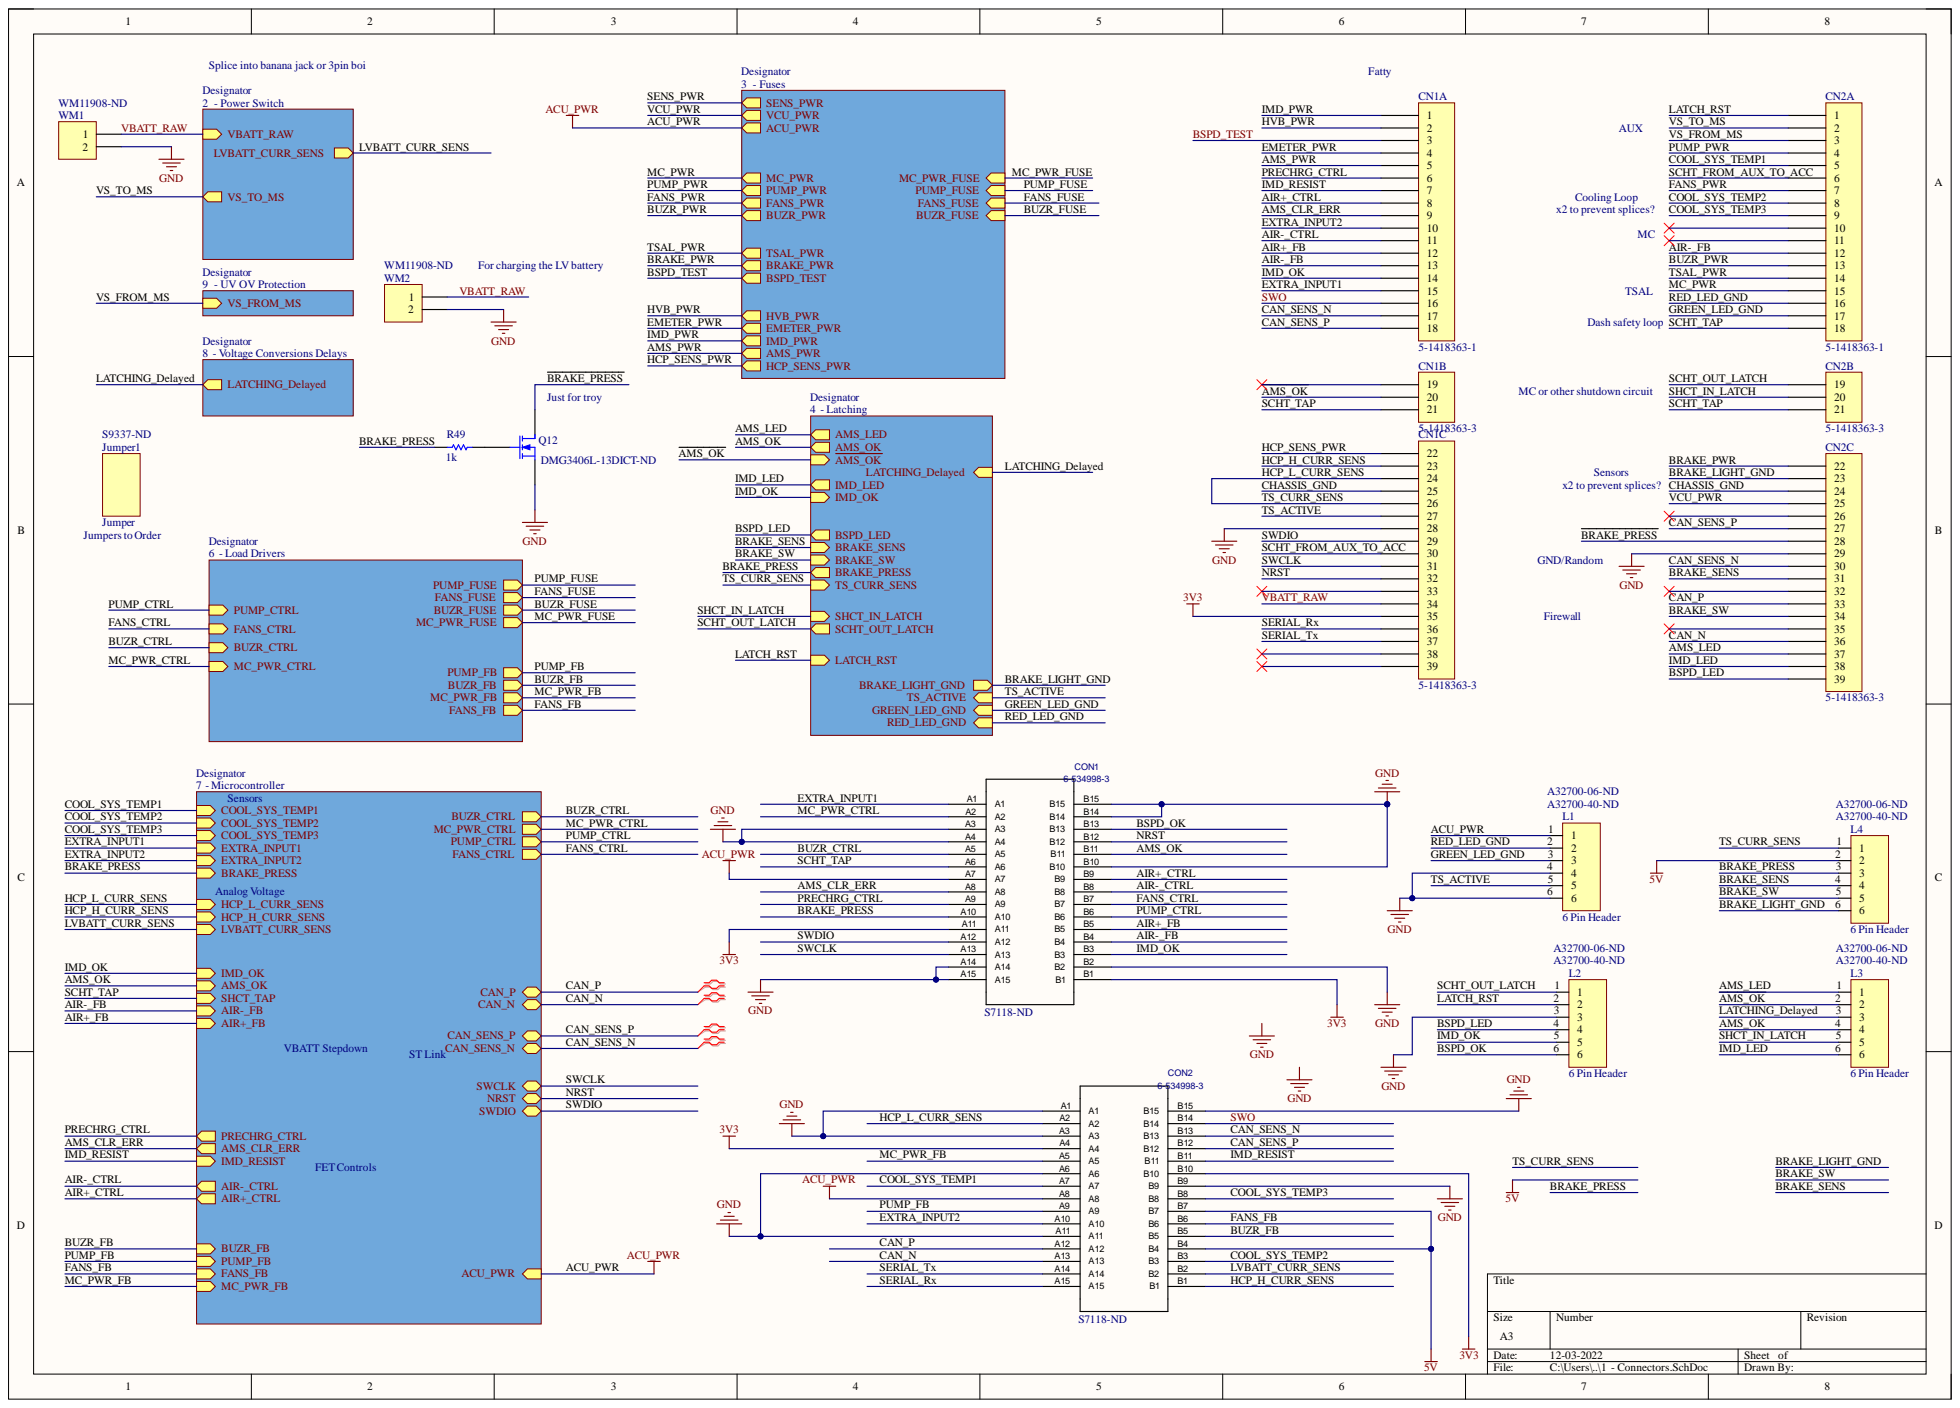
[picture p15: page 1]

A C U_PWR C O O L_SYS_T E MP1 | A 7 A 8 | B 9

B 8 | C O O L_SYS_T E MP3

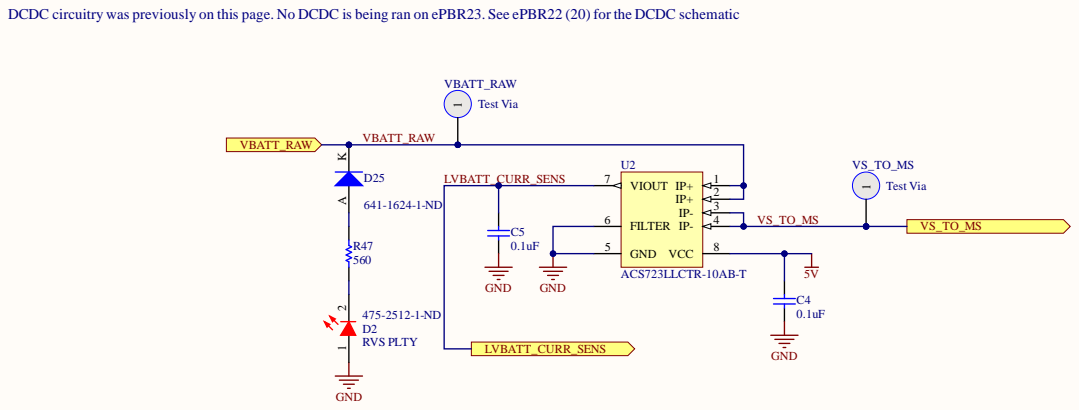
[picture p16: page 2]

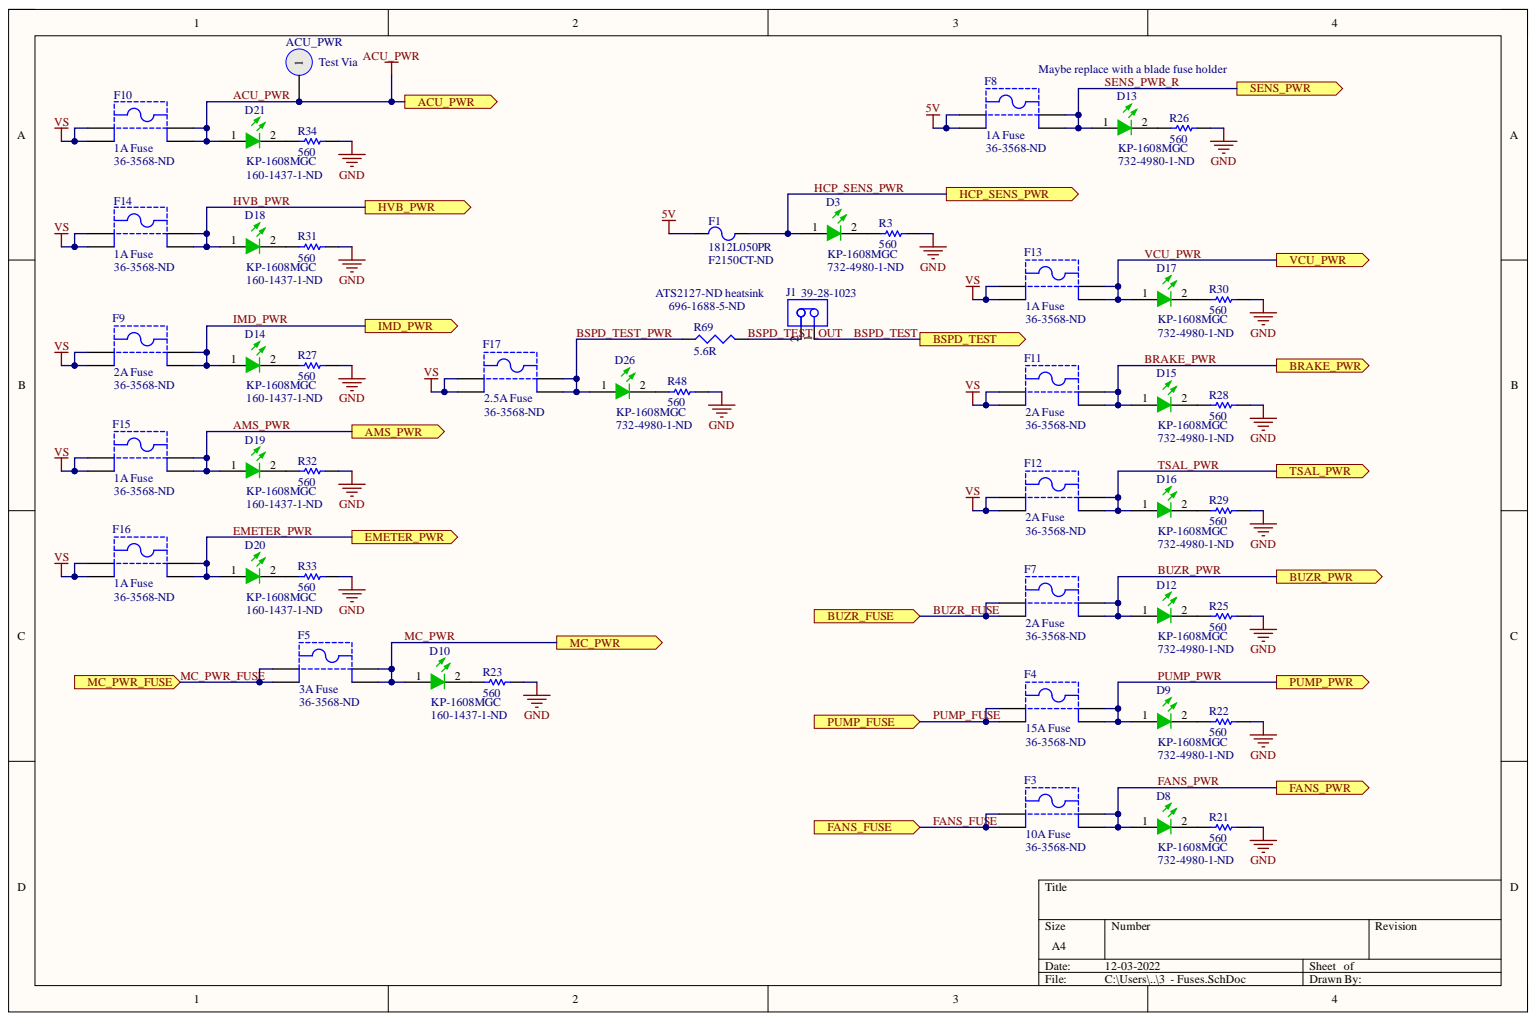
[picture p17: page 3]

Maybe replace with a blade fuse holder

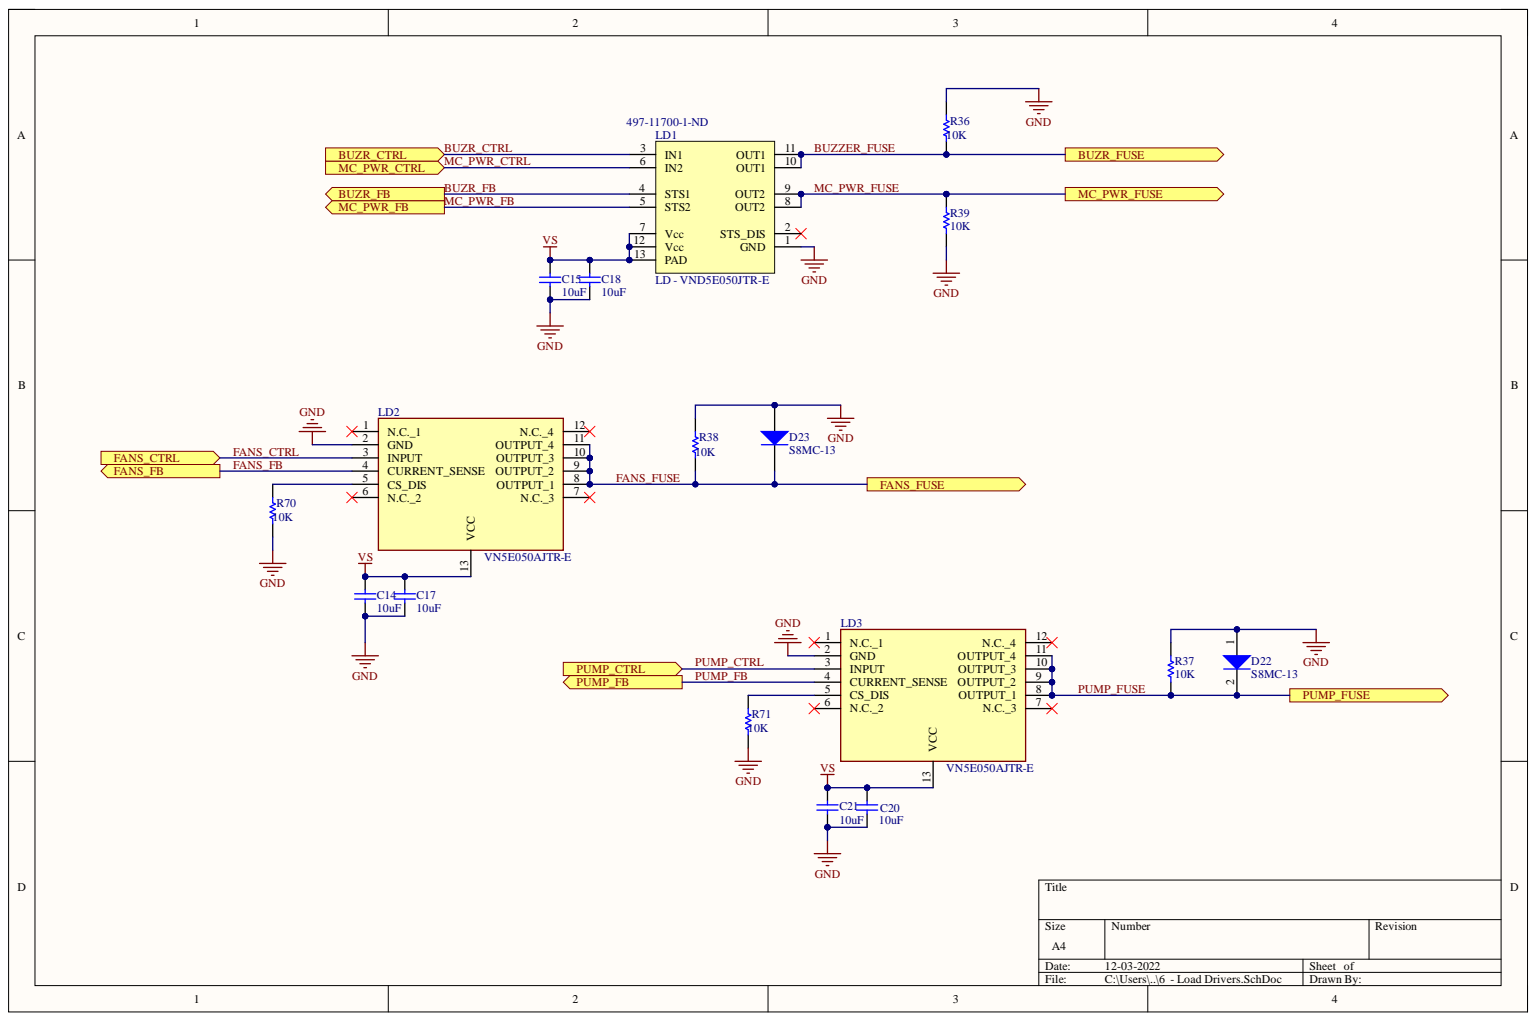
[picture p18: page 4]

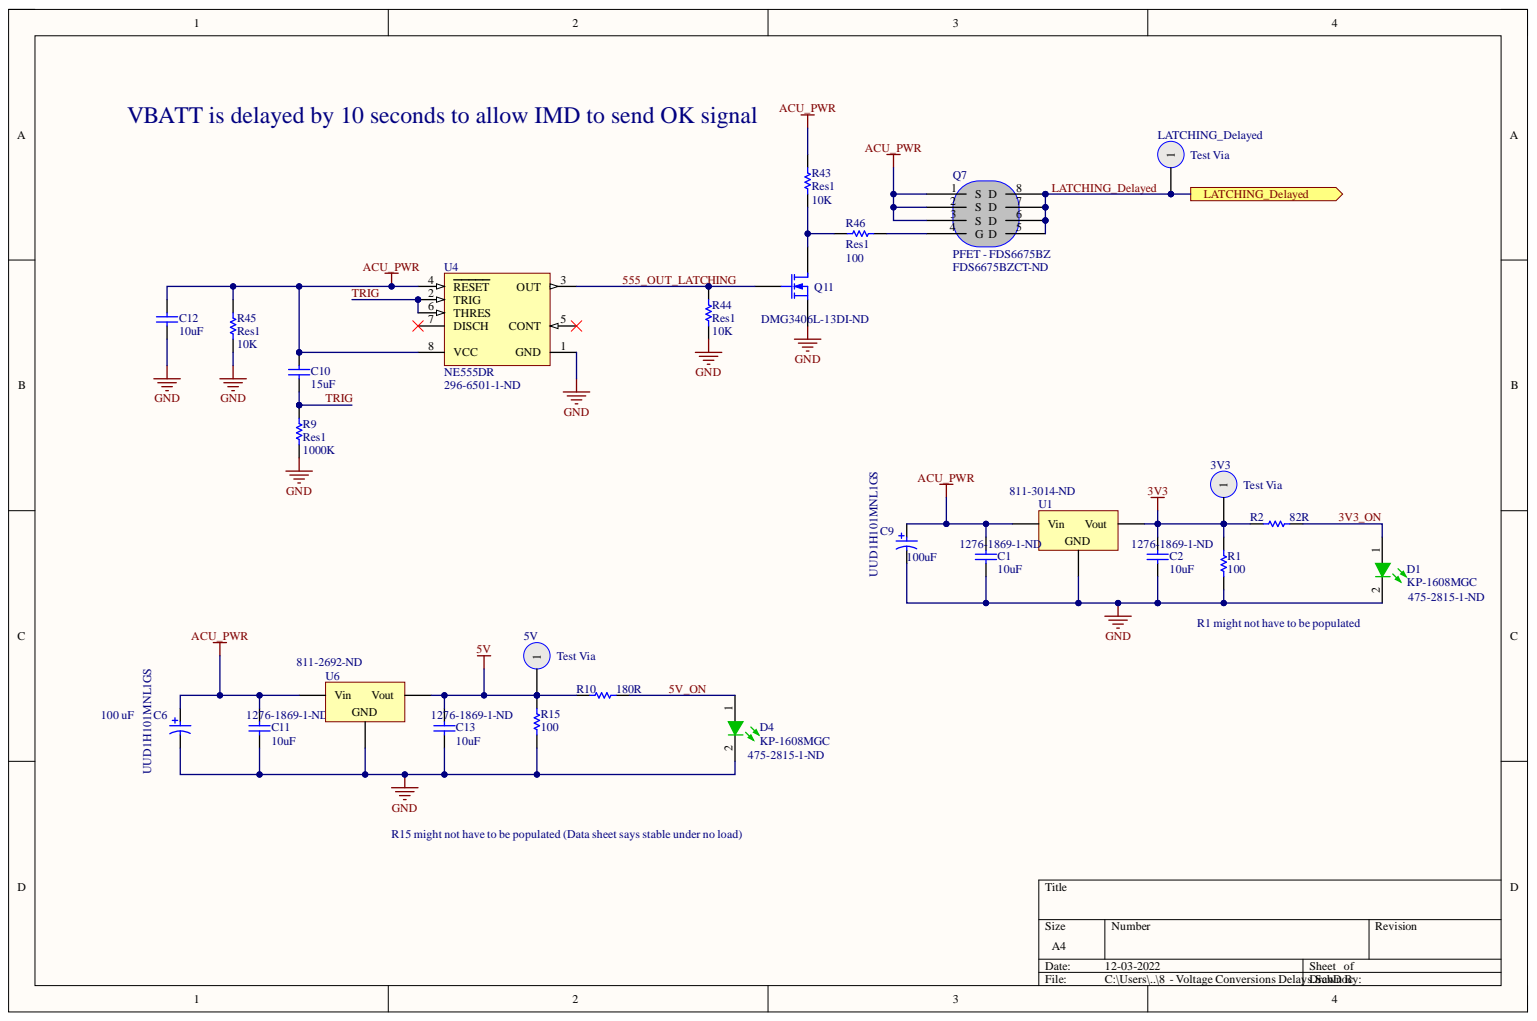
[picture p19: page 5]

VBATT is delayed by 10 seconds to allow IMD to send OK signal

R1 might not have to be populated

R15 might not have to be populated (Data sheetsays stable under no load)

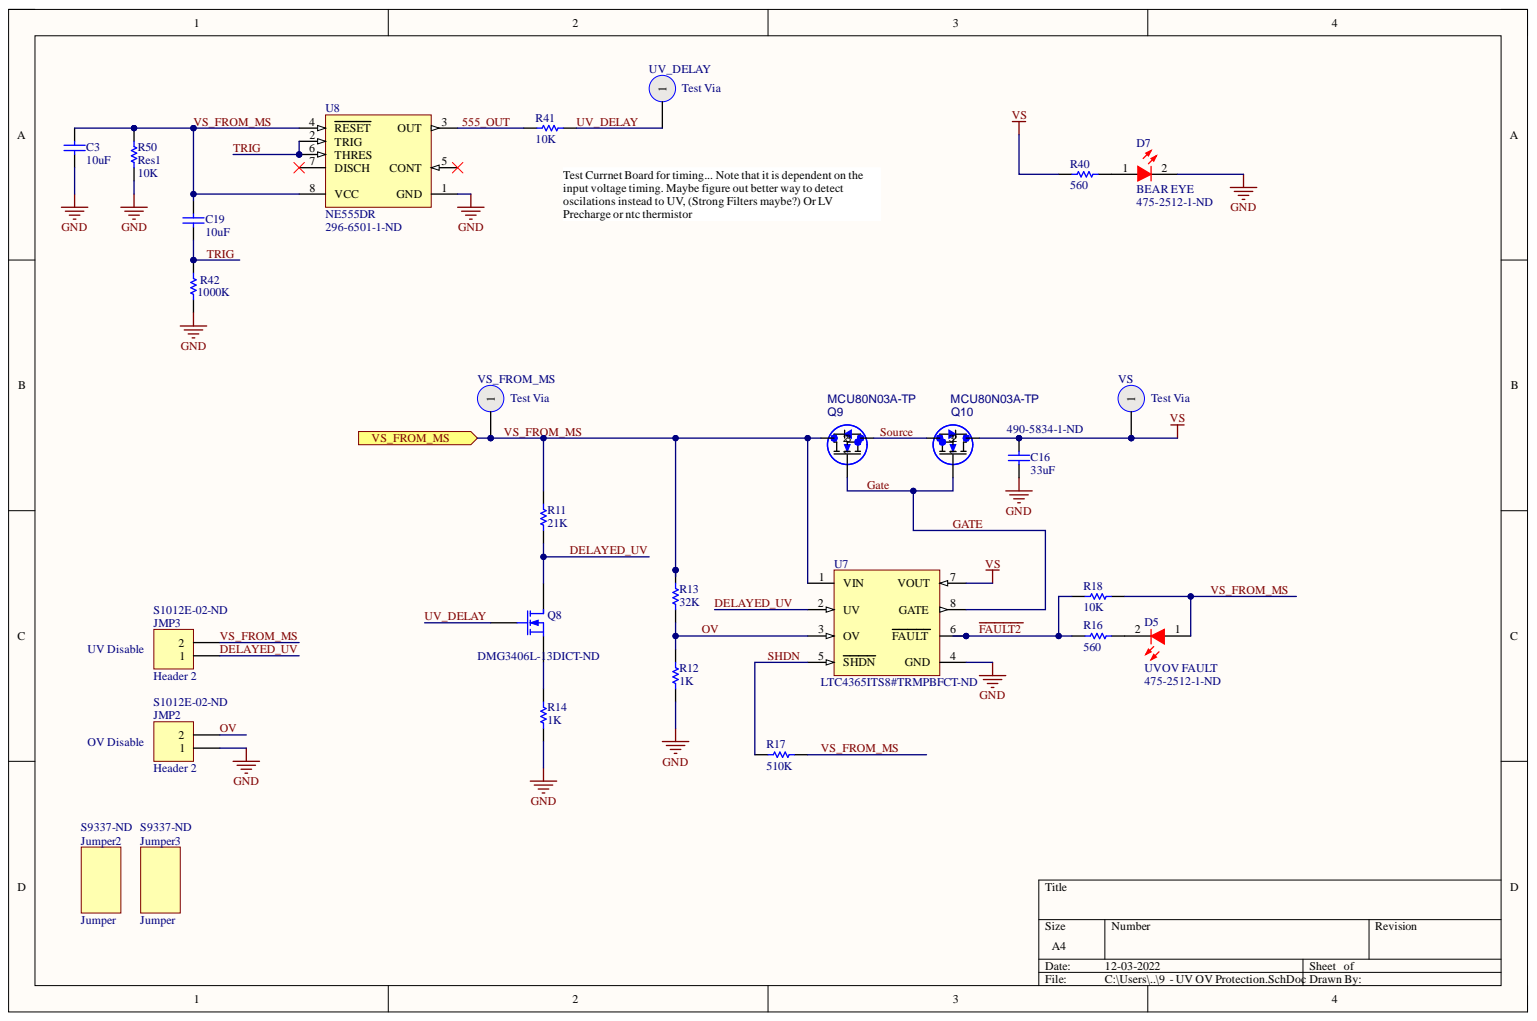
[picture p20: page 6]

Test Currnet Board for timing... Note that it is dependent on the
input voltage timing. Maybe figure out better way to detect
oscilations instead to UV, (Strong Filters maybe?) Or LV
Precharge or ntc thermistor

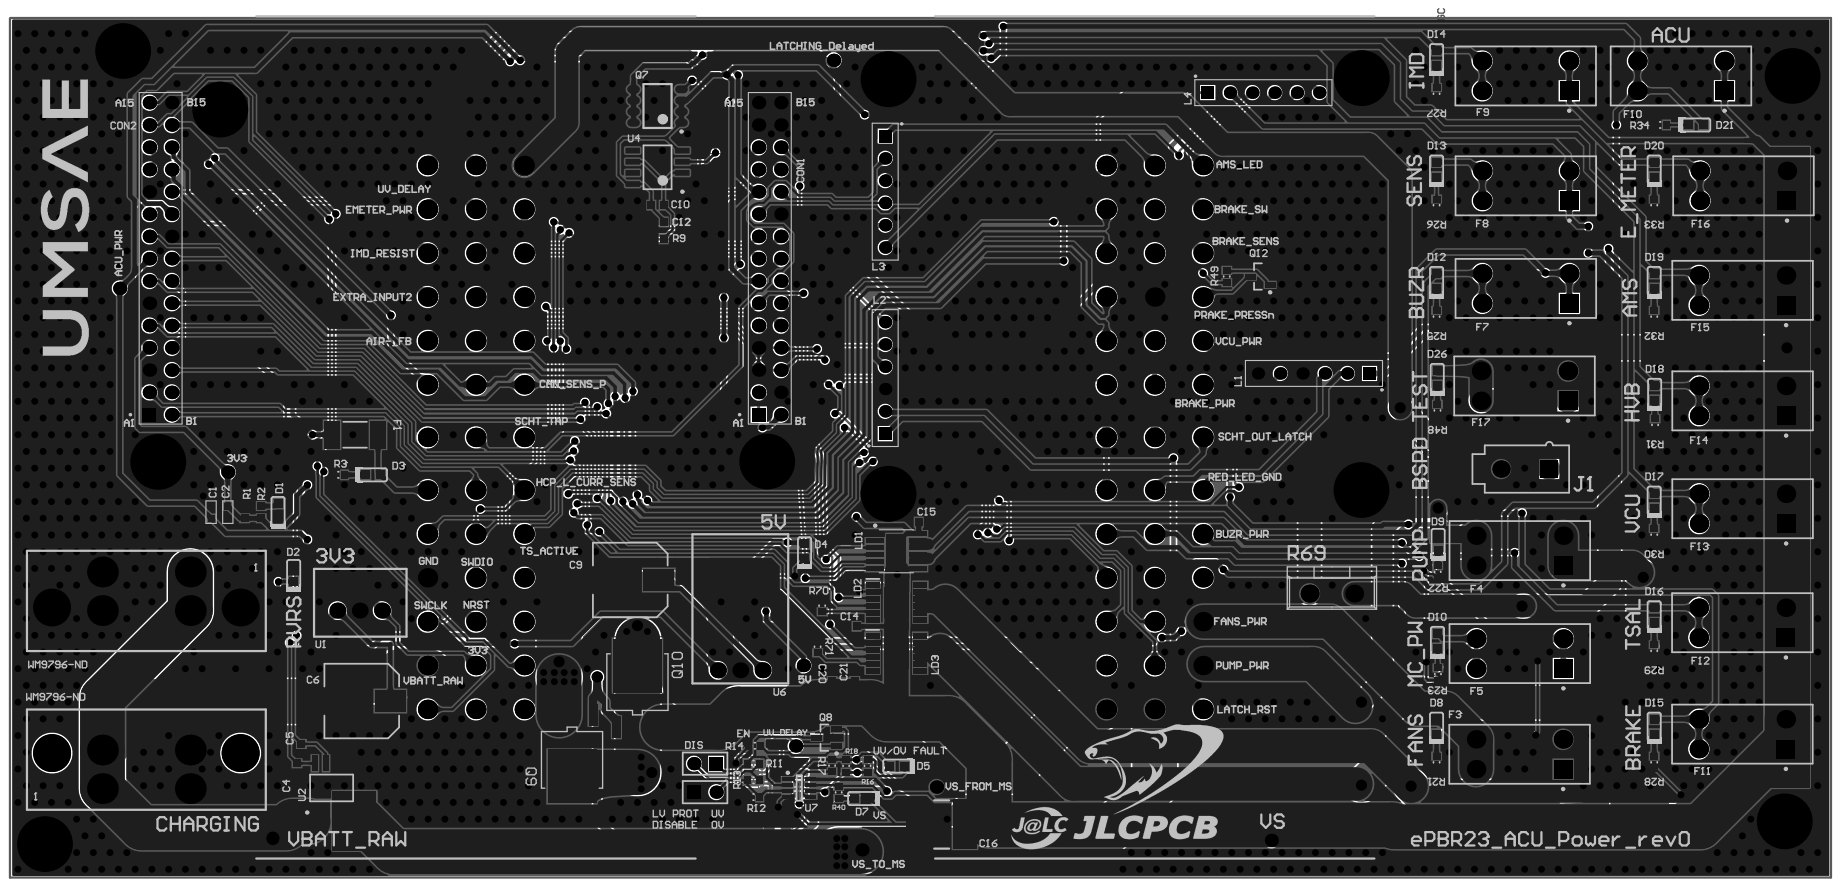
[picture p21: page 7]
