UMSAE-Formula-Electric/PCB-ACU-LVPower/Schematics/ePBR20_ACU_Power_rev0.pdf

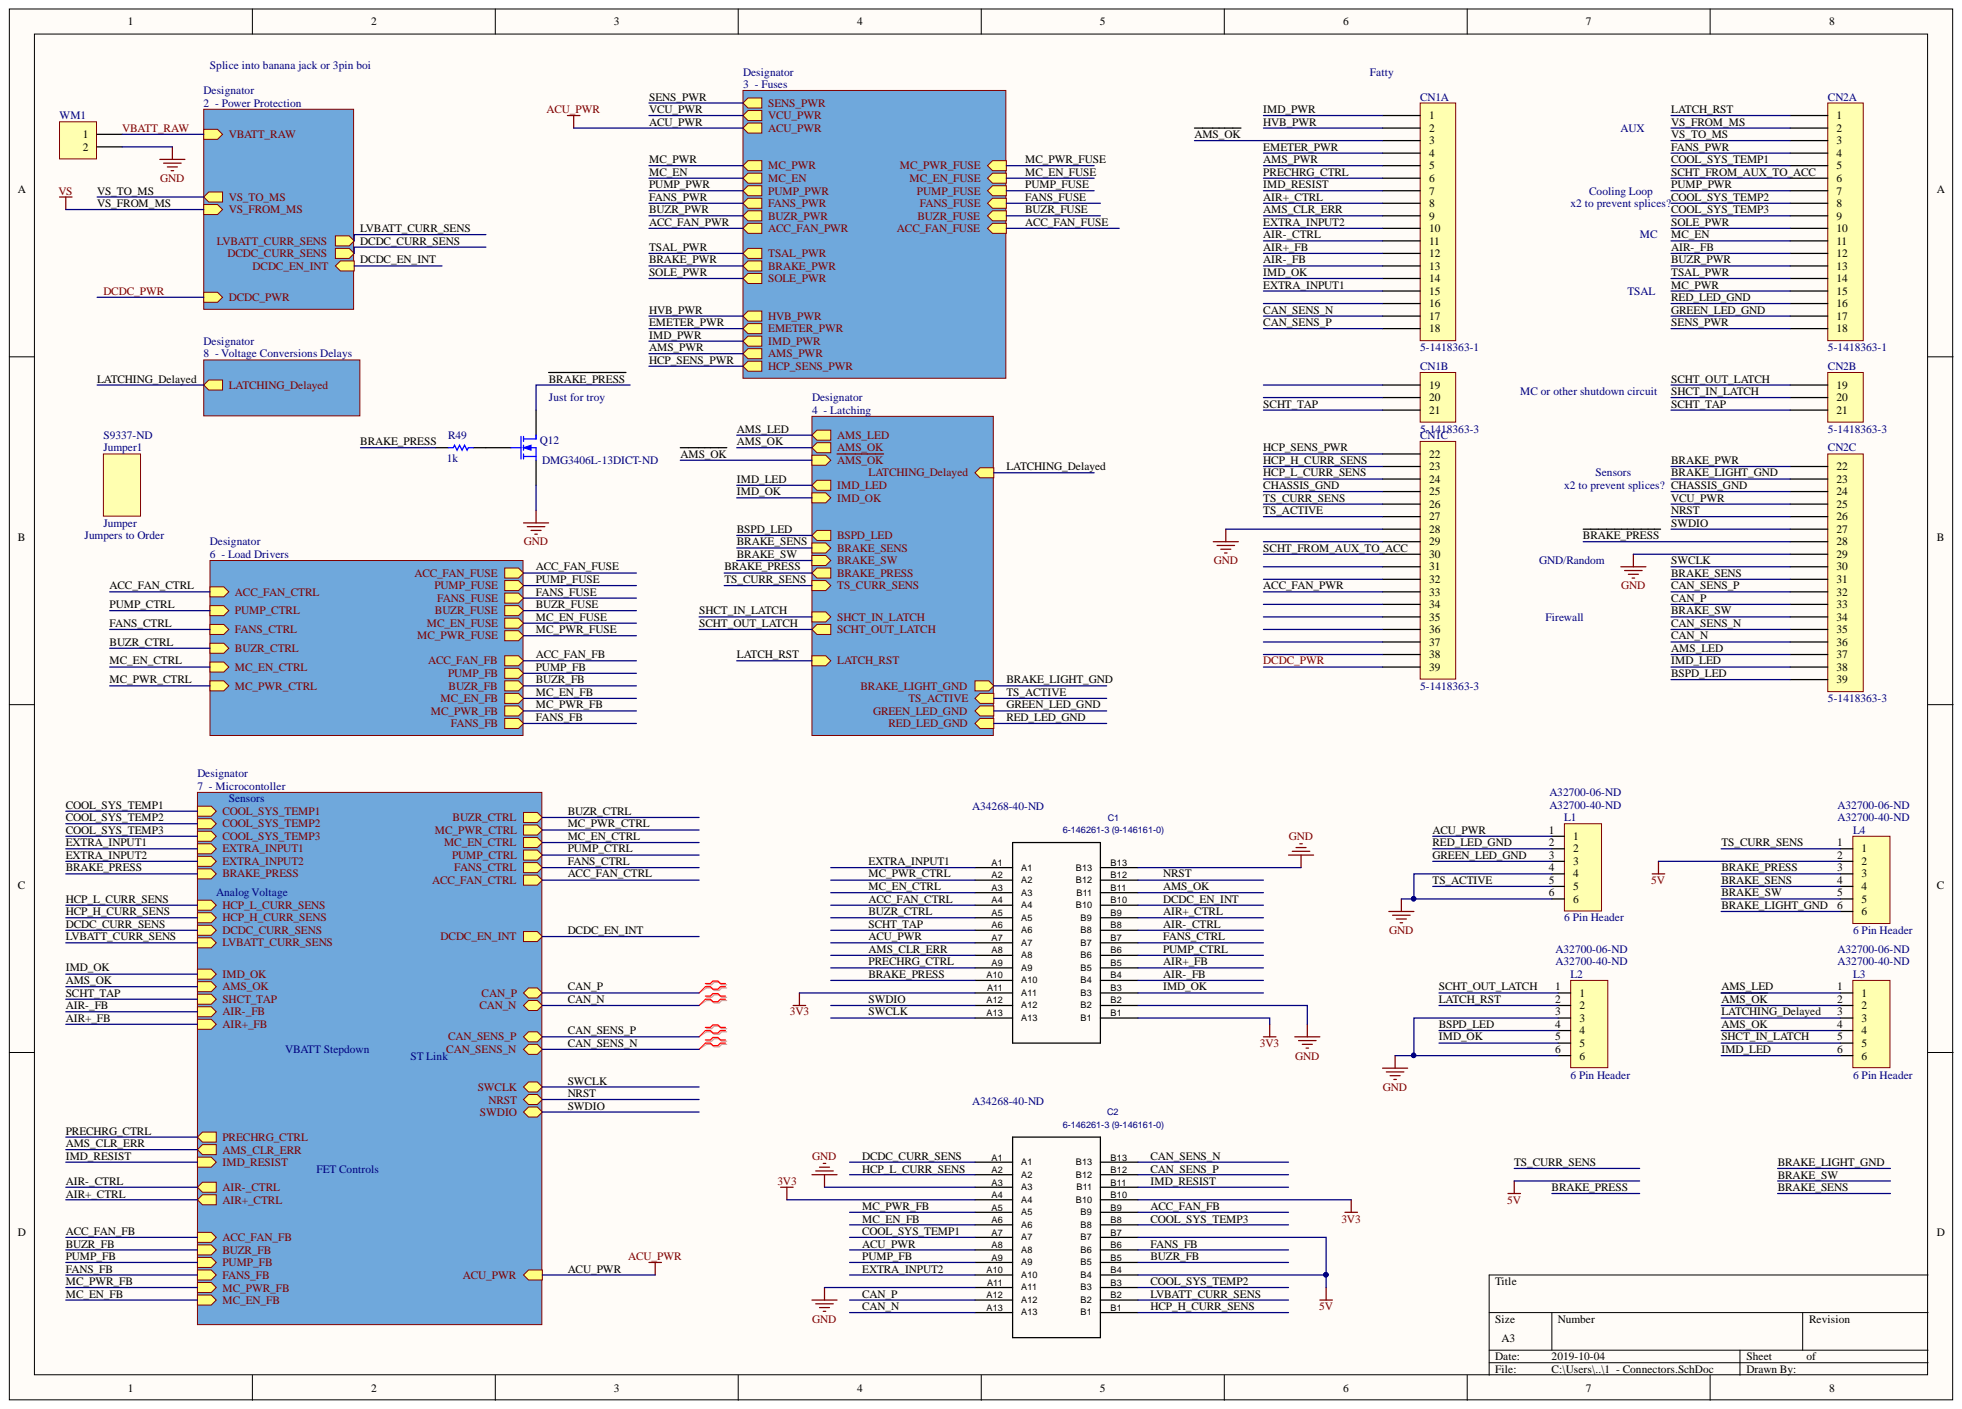
[picture p22: page 1]

Splice into banana jack or 3pin boi

MC or other shutdown circuit

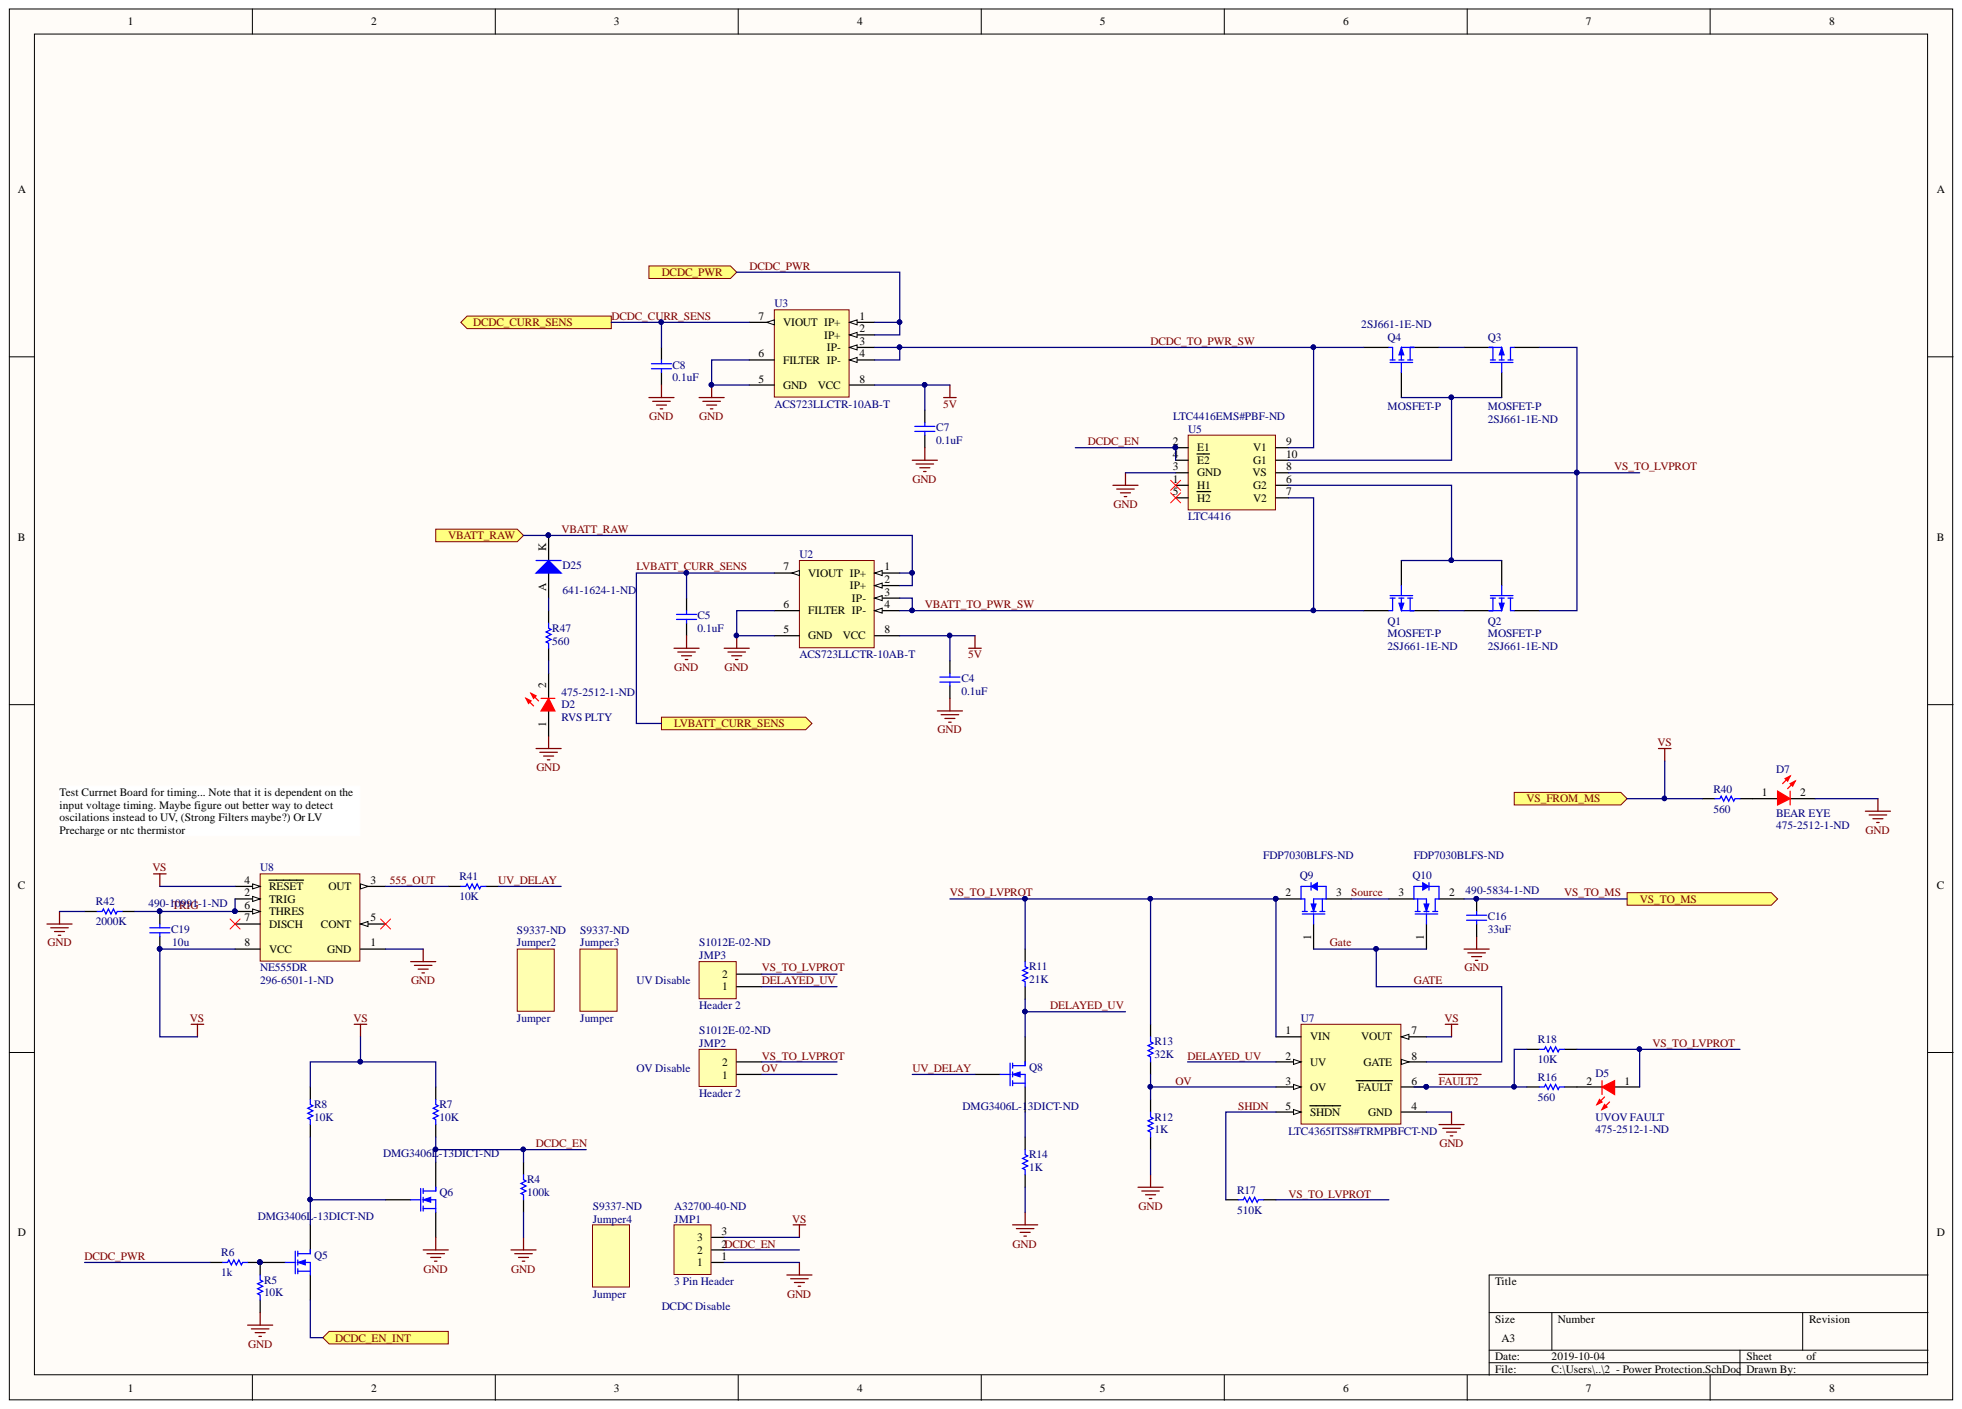
[picture p23: page 2]

Test Currnet Board for timing... Note that it is dependent on the
input voltage timing. Maybe figure out better way to detect
oscilations instead to UV, (Strong Filters maybe?) Or LV
Precharge or ntc thermistor

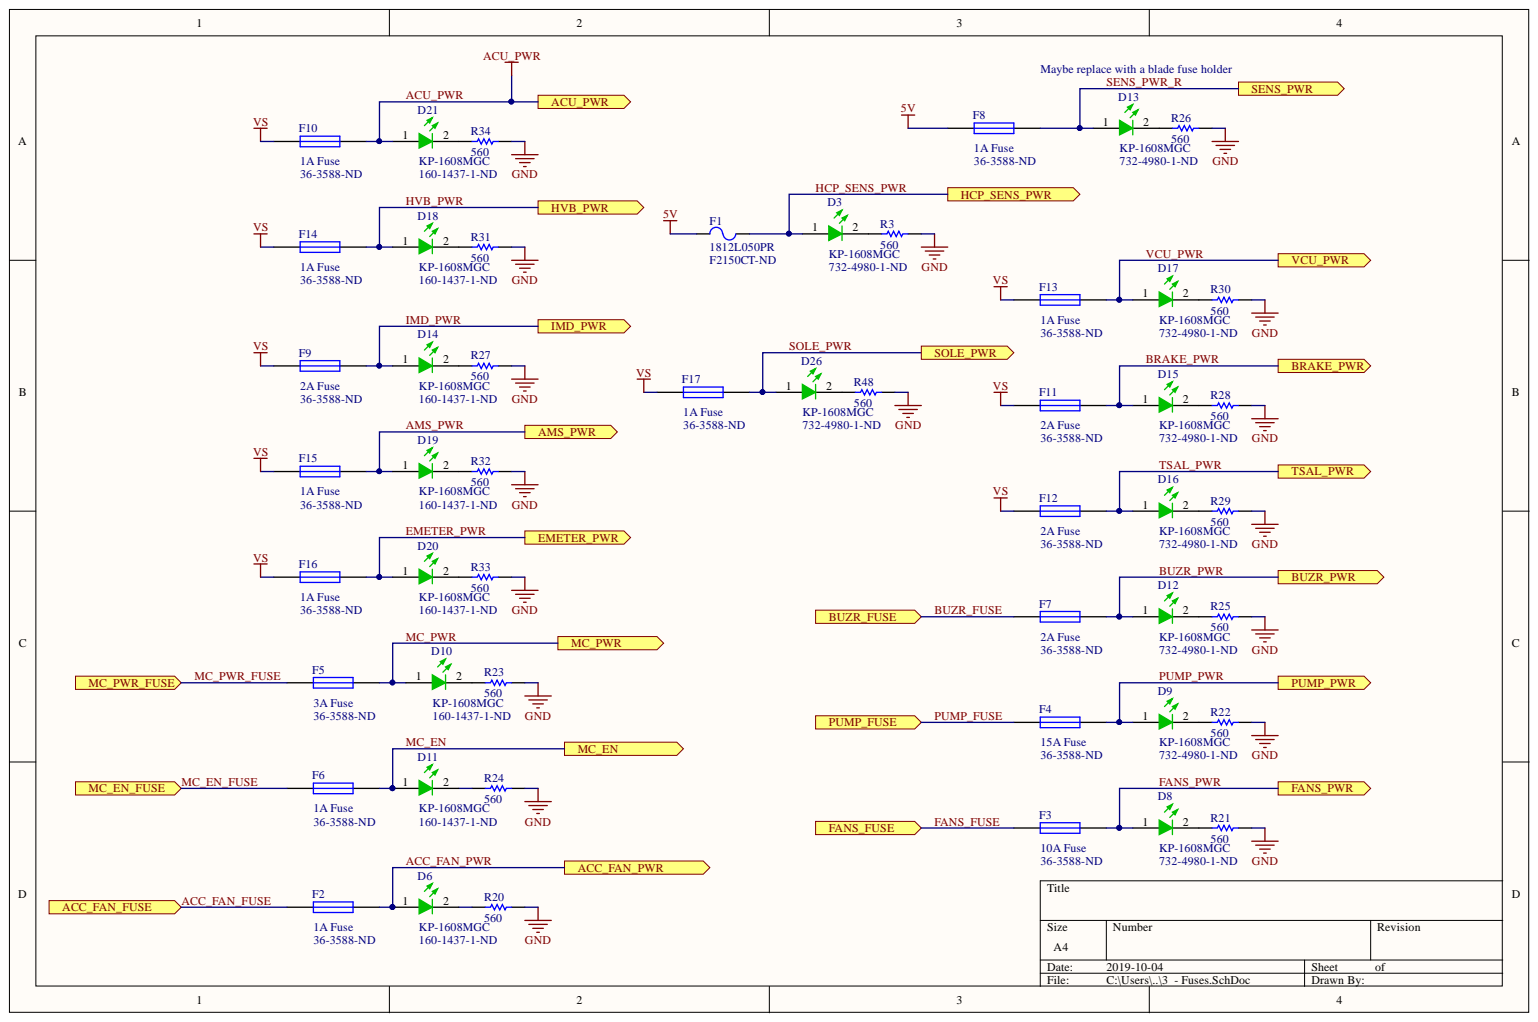
[picture p24: page 3]

Maybe replace with a blade fuse holder

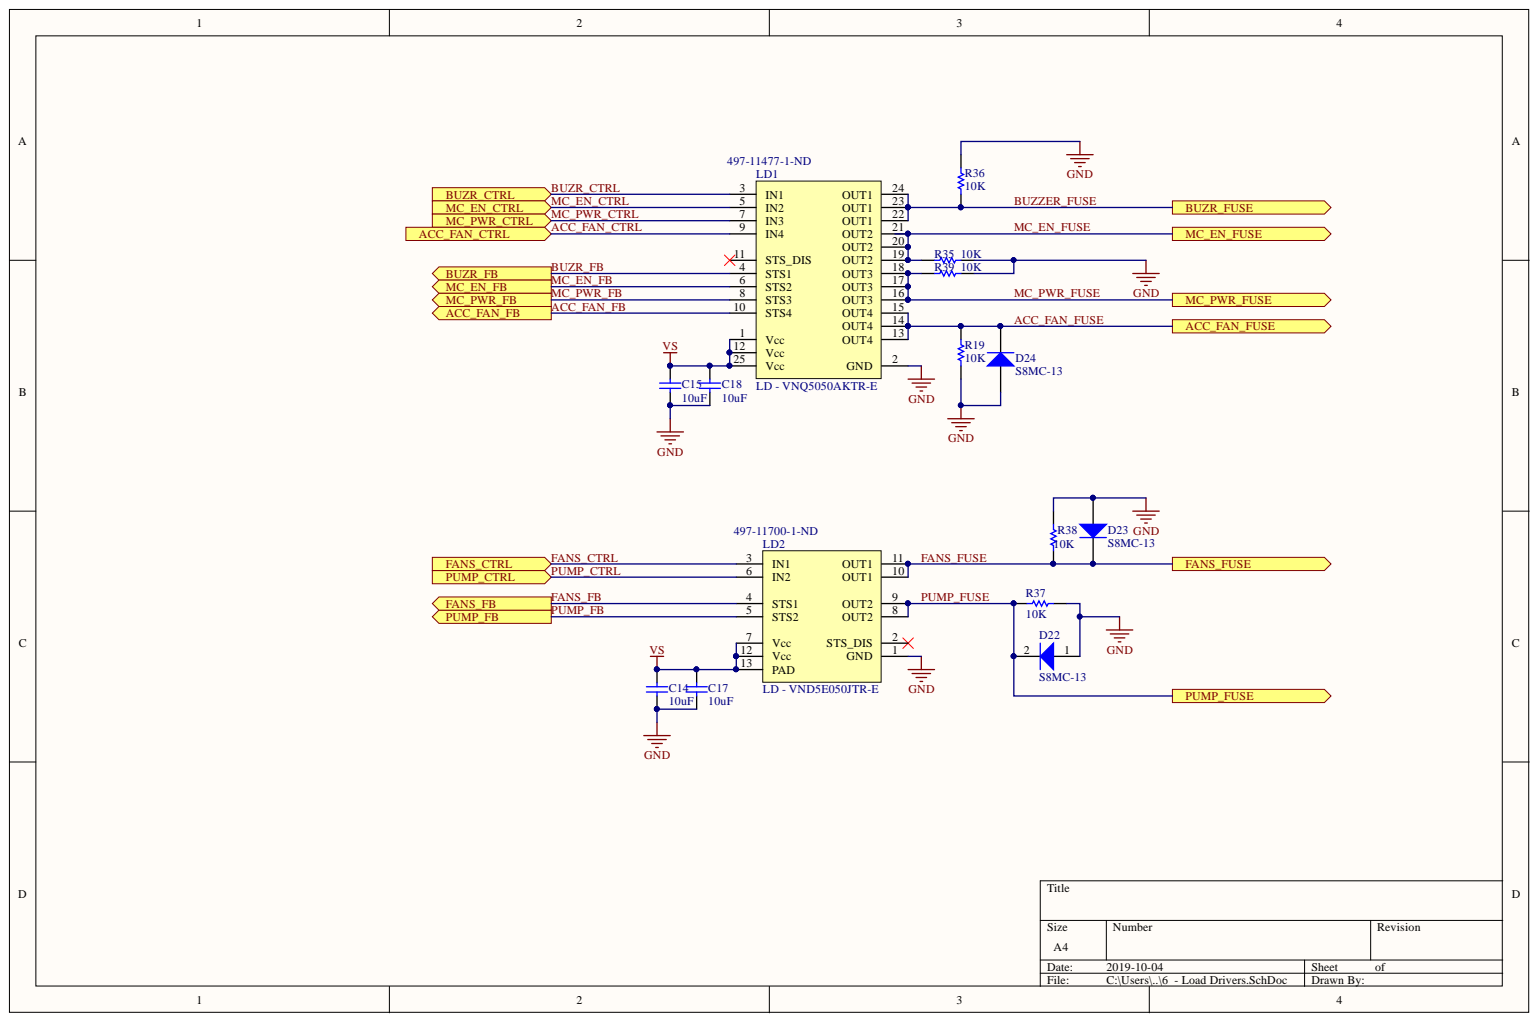
[picture p25: page 4]

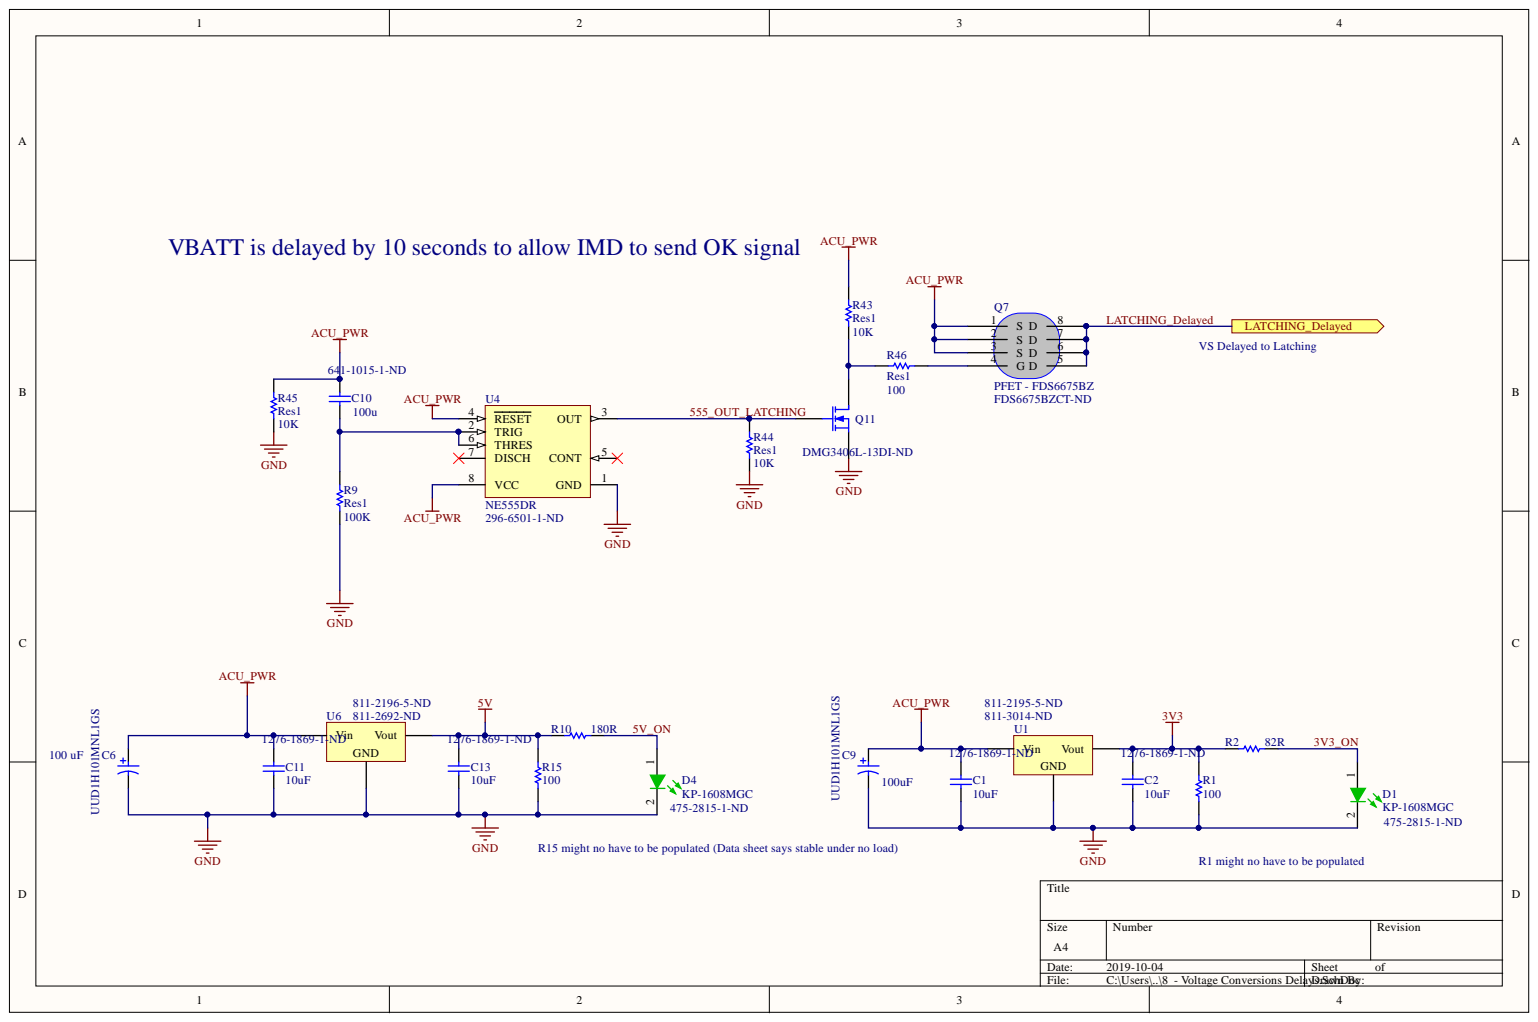
[picture p26: page 5]

VBATT is delayed by 10 seconds to allow IMD to send OK signal

VS Delayed to Latching

R15 might no have to be populated (Data sheet says stable under no load)

R1 might no have to be populated

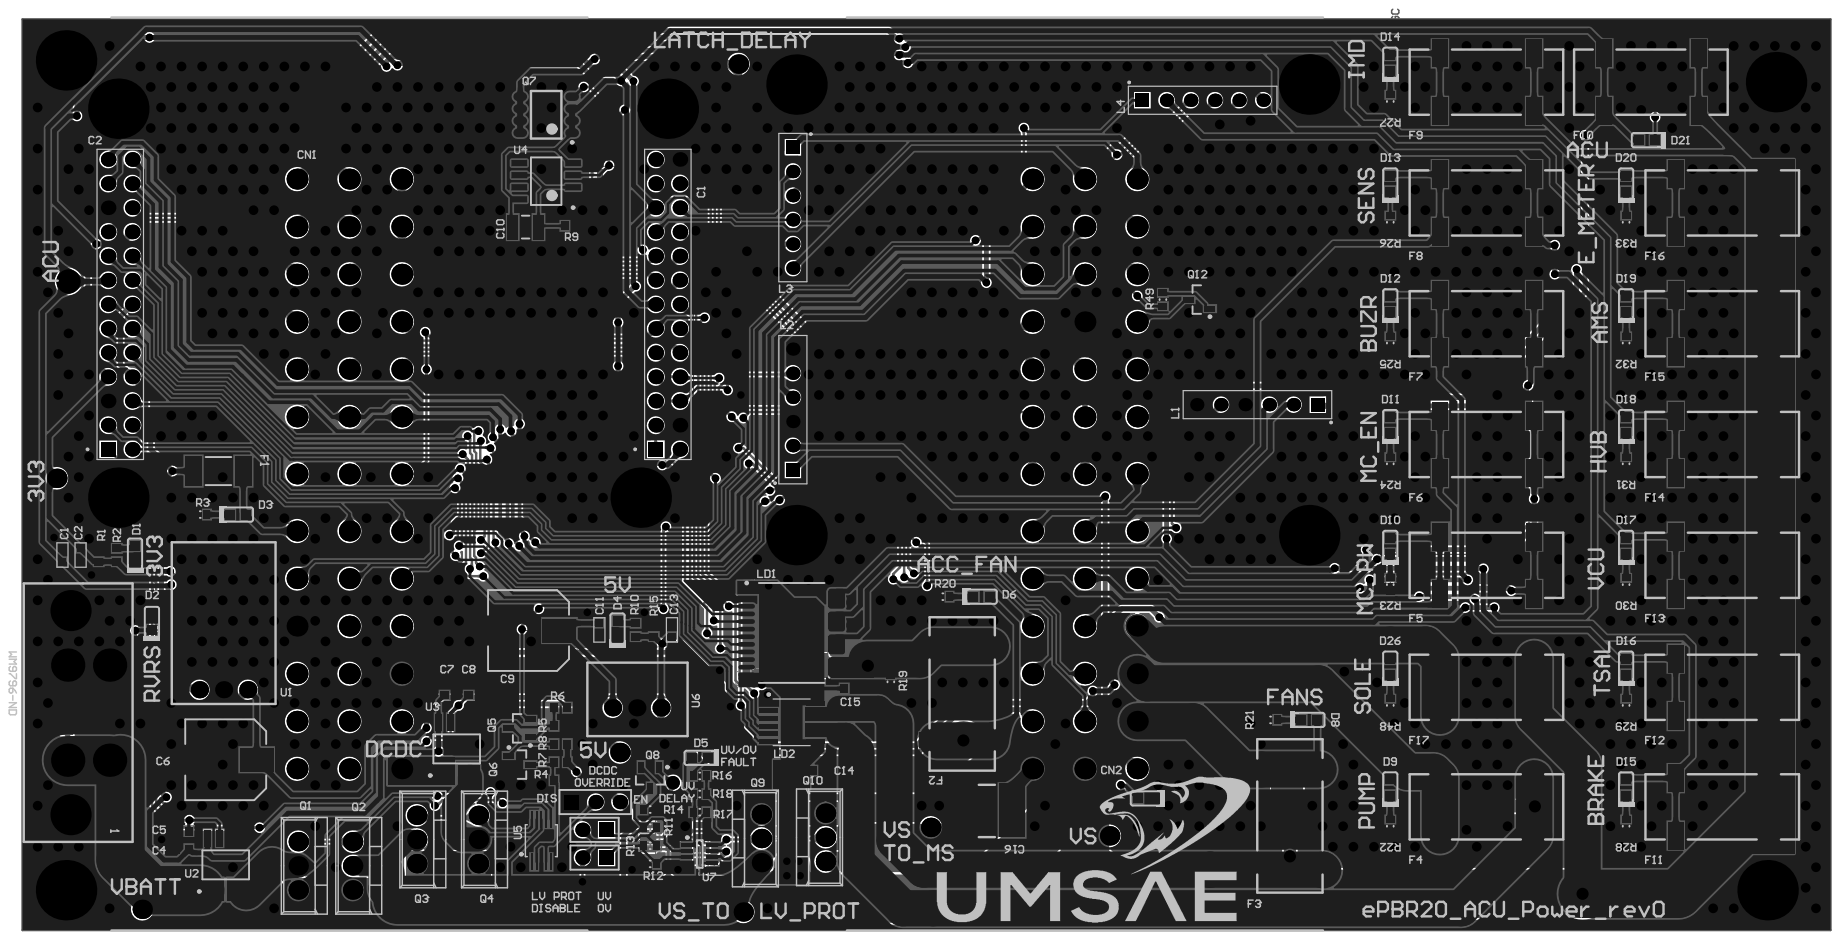
[picture p27: page 6]
