UMSAE-Formula-Electric/PCB-ACU-LVPower/Simulations/ePBR20-ACU-LVPOWER UV-OV Protection and Delay/VoltProt_LTC4416.asc

C1: cap; 47µ
M2: pmos; Si7465DP
M3: pmos; Si7465DP
M4: pmos; Si7465DP
R1: res; 10k
R7: res; 100k
R8: res; 12.5k
R9: res; 120k
R10: res; 18.3k
R11: res; 133k
R12: res; 221k
Rload: res; 34
U1: LTC4416
V1: voltage; PWL(0 0 0.1 5.6 13 5.6 15 20 20 4)
V2: voltage; PWL(0 0 0.1 5.6 2 5.6 3 13 4 10.5 5 13 6 11.1 7 13 12 20 15 12)
Named nets: Vout, 0, Vin, E2, nFault
.tran 20
