UMSAE-Formula-Electric/PCB-ACU-LVPower/Simulations/ePBR20-ACU-LVPOWER UV-OV Protection and Delay/VoltProt_UV_timer_2019.asc

C1: cap; 47µ
C4: cap; 10µ
C5: cap; 47µ
M2: nmos; Si7336ADP
Q1: nmos; Si4850EY
Q2: nmos; Si4850EY
R1: res; 510K
R3: res; 1000k
R4: res; 33k
R5: res; 10K
R6: res; 1000
R9: res; 10k
R11: res; 22k
R12: res; 1000
Rload: res; 34
U1: LTC4365
U3: NE555
V1: voltage; PWL(0 0 0.1 5 13 5 15 20 20 5)
V2: voltage; SINE(12 5 10 15 0 0 100)
Named nets: IN, 0, OUT, Delay, TRIG
.tran 20 startup
LTC4365 - UV, OV and Reverse Supply Protection Controller
Protects 12V Automotive System from -30V to 30V Vin Faults
Input: 12V     Output: 3.5V UV to 18V OV Protection
Note:
  If the simulation model is not found please update with the "Sync Release" command from the "Tools" menu.
  It remains the customer's responsibility to verify proper and reliable operation in the actual application.
  Component substitution and printed circuit board layout may significantly affect circuit performance or reliability
  Contact your local sales representative for assistance. This circuit is distributed to customers only for use with LTC parts
  Copyright © 2011 Linear Technology Inc. All rights reserved.
