UMSAE-Formula-Electric/PCB-ACU-LVPower/Simulations/ePBR20-ACU-LVPOWER UV-OV Protection and Delay/VoltProt_UV_timer_RC_2020.asc

C1: cap; 47µF
C2: cap; 47µF
Q1: nmos; Si4850EY
Q2: nmos; Si4850EY
R1: res; 510K
R2: res; 1k
R4: res; 32k
R5: res; 10K
R6: res; 1000
R10: res; 21k
Rload: res; 34
U1: LTC4365
V1: voltage; SINE(12 3 11 1 0 0 1000)
V2: voltage; PWL(0 0 0.1 5 13 5 15 20 20 5)
V3: voltage; PWL(0 0 0.1 16 2 16 2.05 5 2.1 16)
V4: voltage; SINE(12 3 11 0.1 0 0 1000)
V5: voltage; PWL(0 12 4 12 4.1 0 5 0 5.1 12)
Named nets: IN, 0, OUT, UV
.tran 20 startup
LTC4365 - UV, OV and Reverse Supply Protection Controller
Protects 12V Automotive System from -30V to 30V Vin Faults
Input: 12V     Output: 3.5V UV to 18V OV Protection
Note:
  If the simulation model is not found please update with the "Sync Release" command from the "Tools" menu.
  It remains the customer's responsibility to verify proper and reliable operation in the actual application.
  Component substitution and printed circuit board layout may significantly affect circuit performance or reliability
  Contact your local sales representative for assistance. This circuit is distributed to customers only for use with LTC parts
  Copyright © 2011 Linear Technology Inc. All rights reserved.
Use V1 to show oscillation Problem
Use V2 for normal Operation limits
490-5784-1 8$ ish
