UMSAE-Formula-Electric/PCB-ACU-LVPower/Simulations/ePBR19-ACU-LVpower UV-OV Protection LTSpice/VoltProt_Sim_UV_Timer.asc

C1: cap; 4.7µ
C2: cap; 135µ
D1: diode
D2: diode
M2: pmos4
Q1: nmos; Si4850EY
Q2: nmos; Si4850EY
Q3: nmos; Si4850EY
R1: res; 510K
R2: res; 53818
R3: res; 10K
R4: res; 33966.1
R5: res; 10K
R6: res; 1000
R7: res; 33K
R8: res; 10K
R9: res; 100
R10: res; 10K
Rload: res; 34
U1: LTC4365
U2: NE555
V1: voltage; PWL(0 0 10m 12 70m 12 80m -30 90m -30 100m 12 140m 12 150m 30 160m 30 170m 12 500m 12 530m -5 550m -5 580m 12 1000m 12 1010m 0 1020m 0 1030m 12 1700m 12 1710m 0 1720m 0 1730m 12 6 12 6100m 12 6110m 30 6120m 30 6130m 12 6990m 12 7 0 7010m 0 7020m 12)
Named nets: 0, OUT
.tran 10 startup
LTC4365 - UV, OV and Reverse Supply Protection Controller
Protects 12V Automotive System from -30V to 30V Vin Faults
Input: 12V     Output: 3.5V UV to 18V OV Protection
Note:
  If the simulation model is not found please update with the "Sync Release" command from the "Tools" menu.
  It remains the customer's responsibility to verify proper and reliable operation in the actual application.
  Component substitution and printed circuit board layout may significantly affect circuit performance or reliability
  Contact your local sales representative for assistance. This circuit is distributed to customers only for use with LTC parts
  Copyright © 2011 Linear Technology Inc. All rights reserved.
R2 and R3 are resistors to change UV level
Change C2 to modify delay
