UMSAE-Formula-Electric/PCB-ACU-LVPower/Simulations/ePBR19-ACU-LVpower UV-OV Protection LTSpice/VoltProt_UV_timer_V2_Jolene.asc

C1: cap; 4.7µ
C2: cap; 33µ
M1: nmos; Si7336ADP
Q1: nmos; Si4850EY
Q2: nmos; Si4850EY
R1: res; 510K
R2: res; 21k
R3: res; 1000
R4: res; 32k
R5: res; 10K
R6: res; 1000
R7: res; 10k
R8: res; 270k
R10: res; 1k
Rload: res; 34
U1: LTC4365
U2: NE555
V1: voltage; 5
Named nets: IN, 0, OUT, TRIG, Delay
.tran 20 startup
LTC4365 - UV, OV and Reverse Supply Protection Controller
Protects 12V Automotive System from -30V to 30V Vin Faults
Input: 12V     Output: 3.5V UV to 18V OV Protection
Note:
  If the simulation model is not found please update with the "Sync Release" command from the "Tools" menu.
  It remains the customer's responsibility to verify proper and reliable operation in the actual application.
  Component substitution and printed circuit board layout may significantly affect circuit performance or reliability
  Contact your local sales representative for assistance. This circuit is distributed to customers only for use with LTC parts
  Copyright © 2011 Linear Technology Inc. All rights reserved.
