UMSAE-Formula-Electric/PCB-ACU-LVPower/(list of files, drawings)

Other design files:
1 - Connectors.SchDoc
2 - Battery Sensing and Control.SchDoc
2 - Power Protection.SchDoc
3 - Fuses.SchDoc
6 - Load Drivers.SchDoc
8 - Voltage Conversions Delays.SchDoc
9 - UV OV Protection.SchDoc
10 - Latching Delay.SchDoc
2071366-1/SnapEDApcb.PcbLib
2071366-1/SnapEDAsch.SchLib
ACB_lib.SchLib
AltiumV15/Imported 2024-11-27_20-40-21.lia/2024-11-27_20-40-21.PcbLib
AltiumV15/Imported 2024-11-27_20-40-21.lia/Saftey_loop_relay.SchLib
ePBR24_ACU_Power.PrjPCB
ePBR25_ACU_Power.PrjPCB
G3VM-61VY3(TR05).SchLib
Scrap Schematics - new UVOV protection.SchDoc
SMD Resistors 0603.PcbLib
SMD Resistors 0805.PcbLib
