UMSAE-Formula-Electric/PCB-ACU-LVPower/(commit log)

2021-02-06 ePBR18 and ePBR19 LVBoard Archive
    Files were all mixed up so here are both versions together! Included LTspice files for the simulations on ePBR19 of OV/UV detection.
    [1-Connectors.SchDoc, 2-VoltProtector_CurrSens.SchDoc, 2018_ACU_LVPWR_rev0.PcbDoc, 2018_ACU_LVPWR_rev1.PcbDoc, 3-LoadDrivers.SchDoc, 4-Fuses.SchDoc, PcbLib1.PcbLib, Power_PCB.PrjPcb]
2021-02-06 ePBR20 LVPower Archive
    Has simulations as well for the new OV/UV protection and delayed output to latching power
    [1 - Connectors.SchDoc, 1-Connectors.SchDoc, 2 - Power Protection.SchDoc, 2 - Power Switch.SchDoc, 2-VoltProtector_CurrSens.SchDoc, 2018_ACU_LVPWR_rev0.PcbDoc, 2018_ACU_LVPWR_rev1.PcbDoc, 3 - Fuses.SchDoc]
2022-04-02 ePBR22_rev0
    first print of LV power for 2022
    [1 - Connectors.SchDoc, 3 - Fuses.SchDoc, 6 - Load Drivers.SchDoc, ePBR20_ACU_Power.PrjPCB, ePBR20_ACU_Power.xlsx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]
2022-10-17 Updated fuse holders to a through hole package and removed MC_EN and ACC_FAN circuitry
    [1 - Connectors.SchDoc, 2 - Power Switch.SchDoc, 3 - Fuses.SchDoc, 6 - Load Drivers.SchDoc, 8 - Voltage Conversions Delays.SchDoc, 9 - UV OV Protection.SchDoc, ePBR20_ACU_Power.PrjPCB]
2022-10-17 Fixes issues with nets not saving
    [1 - Connectors.SchDoc, 3 - Fuses.SchDoc, 6 - Load Drivers.SchDoc]
2022-10-18 Added a SCHT_TAP pin for the safety loop LED on the dash
    [1 - Connectors.SchDoc]
2022-10-24 Fixed typos
    [1 - Connectors.SchDoc, 2 - Power Switch.SchDoc, 6 - Load Drivers.SchDoc]
2022-10-30 Changed load drivers and related circuitry
    [1 - Connectors.SchDoc, 6 - Load Drivers.SchDoc, 8 - Voltage Conversions Delays.SchDoc, ePBR20_ACU_Power.PrjPCB]
2022-10-30 Edited traces for clarity
2022-10-30 File name change
    [ePBR20_ACU_Power.PrjPCB, ePBR23_ACU_Power.PrjPCB]
2022-10-30 Added VS to pump and fans power
    [1 - Connectors.SchDoc, 9 - UV OV Protection.SchDoc, ePBR23_ACU_Power.PrjPCB]
2022-11-01 Replaced OV/UV fets with new DPAK package ones
    [9 - UV OV Protection.SchDoc]
2022-11-01 Cleanup of traces and component placement
    [6 - Load Drivers.SchDoc, 9 - UV OV Protection.SchDoc]
2022-11-07 Removed VS from pump and fans power. Miscommunication on what was required for the board.
    [1 - Connectors.SchDoc]
2022-11-07 Changes made after design review. Removed VS from pump and fans power, added a board mount BSPD_TEST connector, removed fet from back of the board
    [2 - Power Switch.SchDoc, 3 - Fuses.SchDoc, 6 - Load Drivers.SchDoc]
2022-11-10 Added the UV/OV fets and new 5V DCDC converter schematics/footprints to the ACB library
    [ACB_lib.SchLib]
2022-11-12 Removed DCDC circuitry, repoured polygons, and cleaned up traces
    Since we aren't running a DCDC this year, removing the circuitry was the best decision. A jumper was considered, however it would make the tracing difficult to work with. See the ACU LV Power board from 2022 (2020) for the DCDC circuitry if it's wanting to be used again
    [1 - Connectors.SchDoc, 2 - Power Switch.SchDoc, 3 - Fuses.SchDoc, 8 - Voltage Conversions Delays.SchDoc, 9 - UV OV Protection.SchDoc, ePBR23_ACU_Power.PrjPCB]
2022-11-12 DCDC circuitry text update
    [2 - Power Switch.SchDoc]
2022-11-12 Via stitching added
    [2 - Power Switch.SchDoc]
2022-11-15 Changed DCDC packages
    [8 - Voltage Conversions Delays.SchDoc]
2022-11-16 Changed charging connector net to VBATT_RAW, changed UV/OV fet trace sizing
    [1 - Connectors.SchDoc]
2022-11-24 Gerber files and NC drill holes generated
    [ePBR23_ACU_Power_rev0.GBL, ePBR23_ACU_Power_rev0.GBO, ePBR23_ACU_Power_rev0.GBP, ePBR23_ACU_Power_rev0.GBS, ePBR23_ACU_Power_rev0.GTL, ePBR23_ACU_Power_rev0.GTO, ePBR23_ACU_Power_rev0.GTP, ePBR23_ACU_Power_rev0.GTS]
2022-11-24 Zipped gerber file
2022-12-02 Via stitching added, Gerber files and NC drill holes generated
    [ePBR23_ACU_Power.PrjPCB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]
2022-12-02 ePBR23 Dec22
    [ePBR23_ACU_Power.PrjPCB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]
2022-12-02 ePBR23 Latching Dec 22
    [ePBR23_ACU_Power.PrjPCB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]
2022-12-05 BOM and pdf created
    [ePBR23_ACU_Power.xlsx]
2022-12-29 ePBR23 LV Power rev0
    [ePBR23_ACU_Power.xlsx]
2024-07-10 Changed File and PCB naming for Branch
    Changed PCB File and Silkscreen PCB Name to from ePBR23 ePBR24 to establish a branch for 2024
    [ePBR23_ACU_Power.PrjPCB, ePBR24_ACU_Power.PrjPCB]
2024-07-16 Adding Text
    Removed ePBR20 PCB File, and begin adding text on schematics to be more descriptive
    [3 - Fuses.SchDoc, 6 - Load Drivers.SchDoc, ePBR23_ACU_Power.PrjPCB]
2024-07-16 Removed 2020 Logs and Project outputs
    [ePBR20_ACU_Power.xlsx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]
2024-09-08 Fuse Schematic Cleaned
    [2 - Power Switch.SchDoc, 3 - Fuses.SchDoc]
2024-09-09 Leavy Seal Connecter Switch
    -Leavy Seal Connecters are now oriented correctly
    [1 - Connectors.SchDoc, 2 - Power Switch.SchDoc]
2024-09-22 Small Changes (not that noticable)
    [1 - Connectors.SchDoc, 3 - Fuses.SchDoc]
2024-10-06 Fuse for LV Battery added
    [1 - Connectors.SchDoc, 2 - Power Switch.SchDoc, 3 - Fuses.SchDoc, ePBR25_ACU_Power.PrjPCB]
2024-10-08 added power for status leds
    [1 - Connectors.SchDoc, 3 - Fuses.SchDoc]
2024-10-27 new power monitor ic
    [1 - Connectors.SchDoc, 2 - Power Switch.SchDoc, 3 - Fuses.SchDoc, 6 - Load Drivers.SchDoc, 8 - Voltage Conversions Delays.SchDoc, ACB_lib.SchLib, ePBR25_ACU_Power.PrjPCB]
2024-10-27 added via stitches and ground planes back
    [2 - Power Switch.SchDoc, 6 - Load Drivers.SchDoc, ACB_lib.SchLib, ePBR25_ACU_Power.PrjPCB]
2024-10-28 LV board small change fixes
    [1 - Connectors.SchDoc, 2 - Battery Sensing.SchDoc, 2 - Power Switch.SchDoc, 3 - Fuses.SchDoc, 6 - Load Drivers.SchDoc, 9 - UV OV Protection.SchDoc, ePBR25_ACU_Power.PrjPCB]
2024-10-28 PCB finalized
    [1 - Connectors.SchDoc]
2024-10-29 Small Changes
    [1 - Connectors.SchDoc]
2024-10-30 added fuse to power for accumulator fan
    [1 - Connectors.SchDoc, 3 - Fuses.SchDoc]
2024-11-03 Revert "added fuse to power for accumulator fan"
    This reverts commit c68b77265e34a9307308f0dac1fc56528e417a0d.
    [1 - Connectors.SchDoc, 3 - Fuses.SchDoc]
2024-11-03 Added fuse to power accumulator fans
    [1 - Connectors.SchDoc, 3 - Fuses.SchDoc, ePBR25_ACU_Power.PrjPCB]
2024-11-10 Trace Cleaning
    -Updating Traces For Power Monitor Signals
    -Updating Traces For Software
    -Other Traces Cleaned and routed
    [1 - Connectors.SchDoc, 10 - Saftey Loop Disconnect.SchDoc, 2 - Battery Sensing.SchDoc, 3 - Fuses.SchDoc, 9 - UV OV Protection.SchDoc, ePBR25_ACU_Power.PrjPCB]
2024-11-12 Latching Delay Circuitry Added
    New Circuitry Added to disconnect safety loop when latching is delayed
    [1 - Connectors.SchDoc, 10 - Latching Delay.SchDoc, 10 - Saftey Loop Disconnect.SchDoc, 2 - Battery Sensing.SchDoc, 3 - Fuses.SchDoc, 6 - Load Drivers.SchDoc, 8 - Voltage Conversions Delays.SchDoc, 9 - UV OV Protection.SchDoc]
2024-11-18 Small Update to Latching Delay
    [10 - Latching Delay.SchDoc]
2024-11-26 Lots of Changes
    -Increased Trace width for VS Signals for Accumulator Fans to use 12 A
    - Added a Relay to disconnet saftey loop when latching delay is on
    -More trace cleaning and schematic cleaning
    [1 - Connectors.SchDoc, 10 - Latching Delay.SchDoc, 2 - Battery Sensing.SchDoc, 3 - Fuses.SchDoc, 6 - Load Drivers.SchDoc, 8 - Voltage Conversions Delays.SchDoc, 9 - UV OV Protection.SchDoc]
2024-11-29 Big Changes
    Twoe new relays added for Accumulator fans, one for turing on GLV.
    Traces for beginning of GLV are different in that they dont loop out and back in.
    [1 - Connectors.SchDoc, 10 - Latching Delay.SchDoc, 2 - Battery Sensing and Control.SchDoc, 2 - Battery Sensing.SchDoc, 2024-11-27_20-40-21.PcbLib, 3 - Fuses.SchDoc, 6 - Load Drivers.SchDoc, 8 - Voltage Conversions Delays.SchDoc]
2024-12-01 Big Fixes
    -Fix ACC fan load driver circuit
    -New GLV Relay thats latching instead of non latching
    -New latching delay relay
    [1 - Connectors.SchDoc, 10 - Latching Delay.SchDoc, 2 - Battery Sensing and Control.SchDoc, 6 - Load Drivers.SchDoc, SnapEDApcb.PcbLib, SnapEDAsch.SchLib, ePBR25_ACU_Power.PrjPCB]
2024-12-02 Added New GLV Relay
    [1 - Connectors.SchDoc, 10 - Latching Delay.SchDoc, 2 - Battery Sensing and Control.SchDoc, 3 - Fuses.SchDoc, 6 - Load Drivers.SchDoc, 8 - Voltage Conversions Delays.SchDoc, 9 - UV OV Protection.SchDoc, ePBR25_ACU_Power.PrjPCB]
